gth758y/poe_garHAge/board_front.png

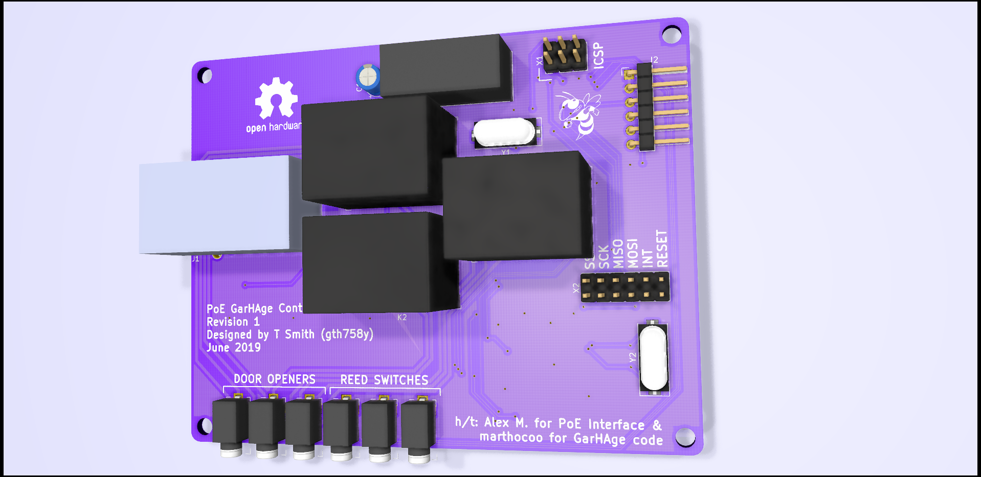
board_front.png
