gth758y/poe_garHAge/board_rear.png

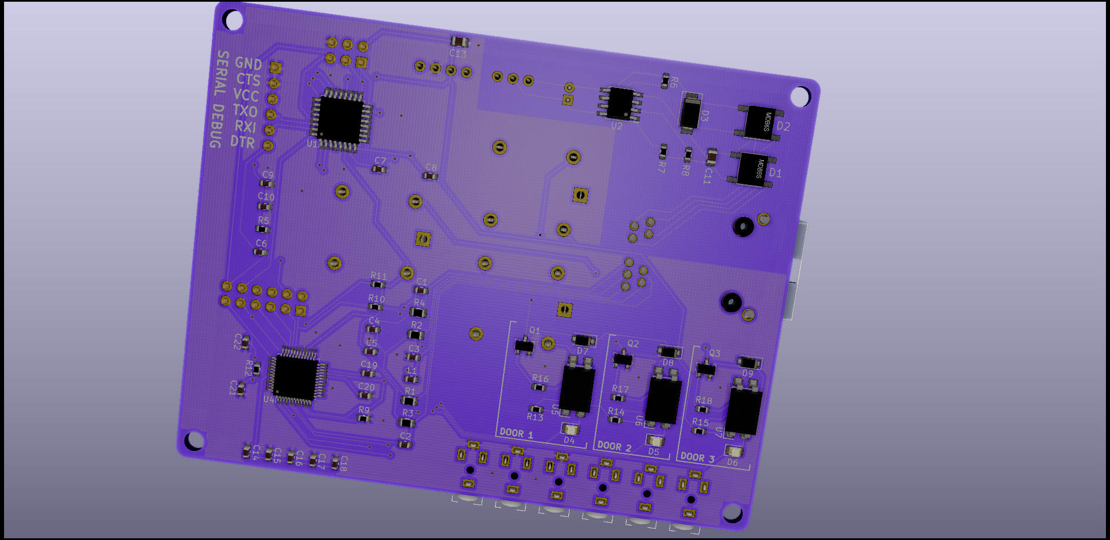
board_rear.png
