gth758y/poe_garHAge/README.md

# poe_garHAge

in-work version of the PoE powered, MQTT garage door controller
