gth758y/poe_garHAge/kicad/screenshots.pptx

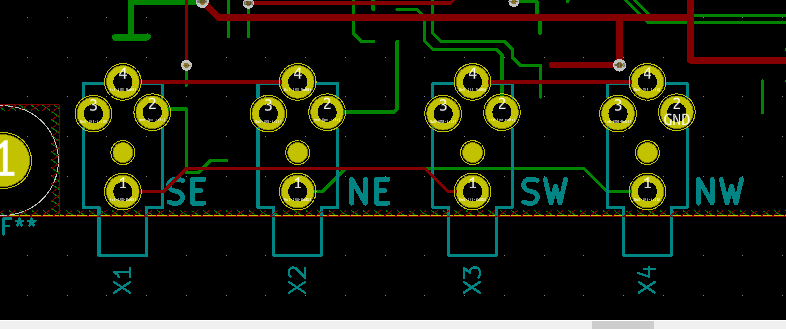
[picture p3: figure]

## Slide 2

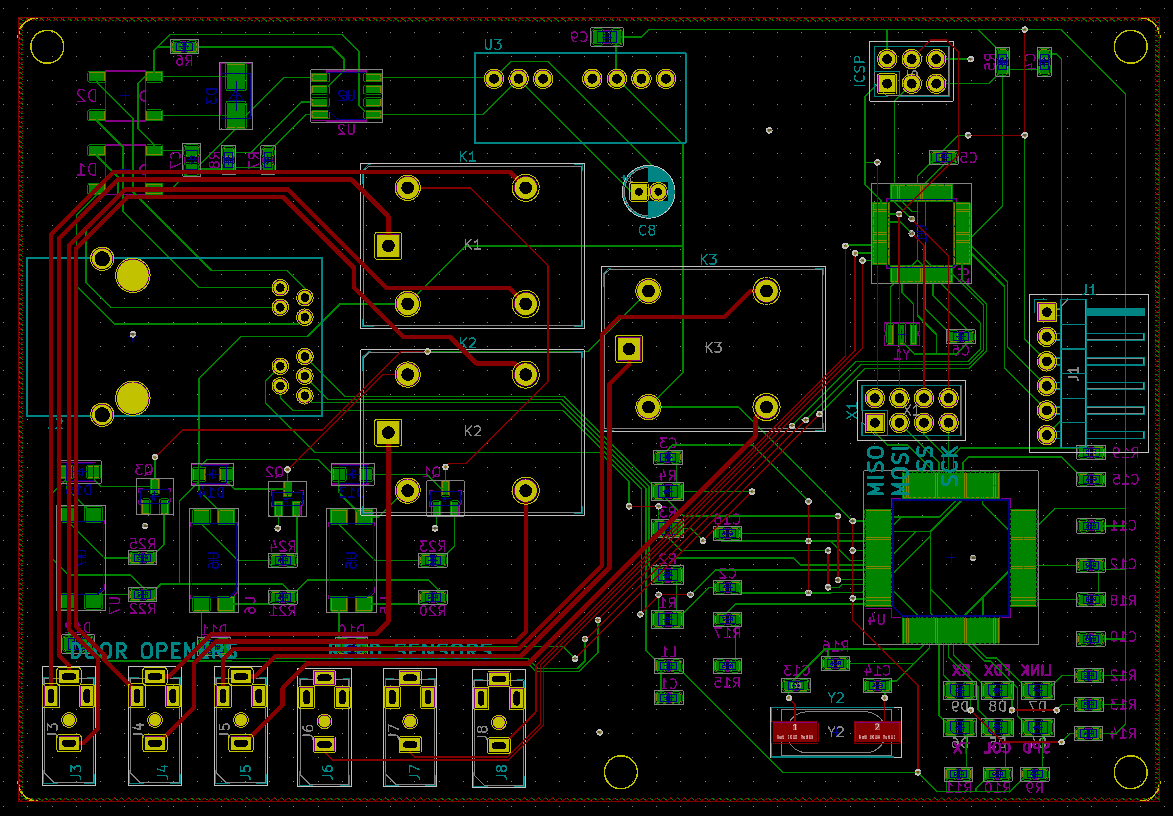
[picture p4: figure]

## Slide 3

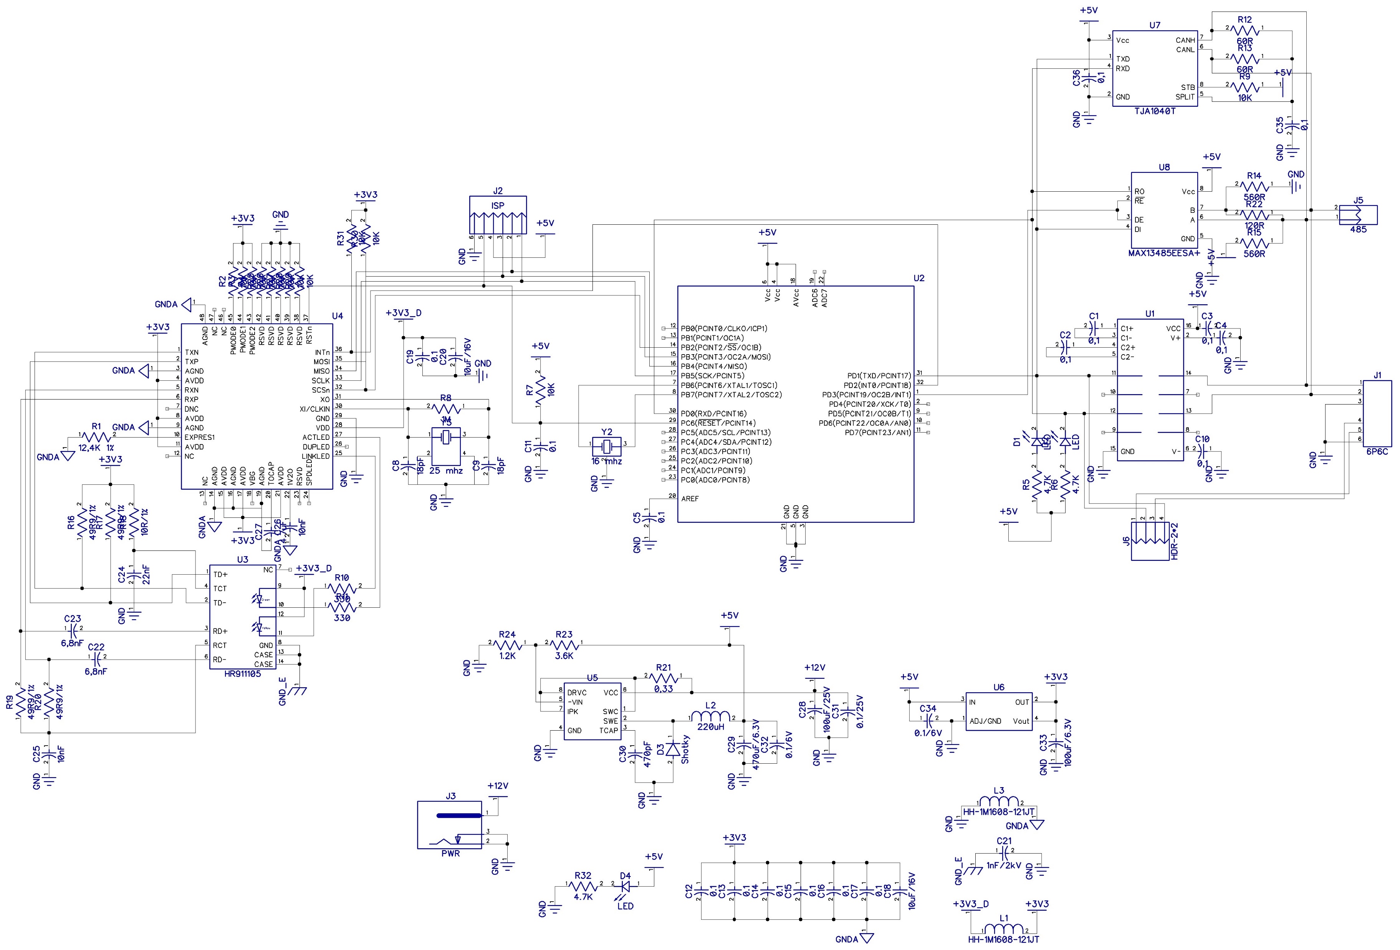
[picture p5: figure]

## Slide 4

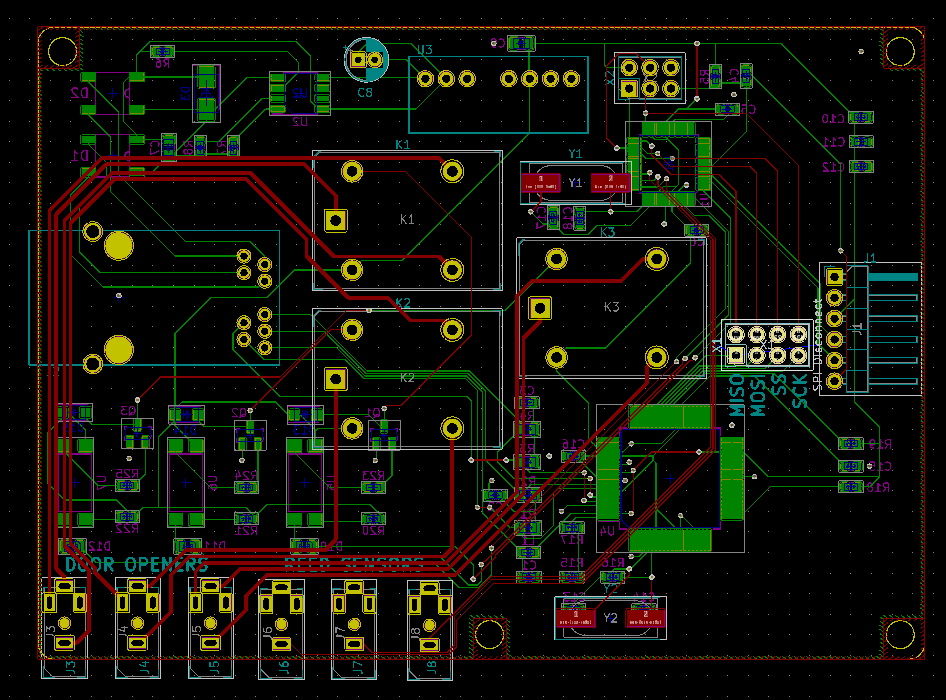
[picture p6: figure]
