gth758y/poe_garHAge/kicad/cad/PG02S4803A_markings.png

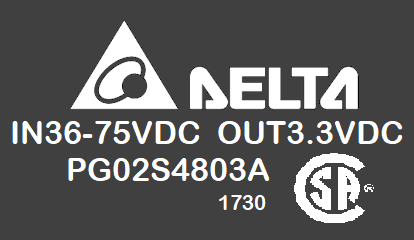
kicad/cad/PG02S4803A_markings.png
