gth758y/poe_garHAge/garHAge_v2_BOM.xlsx

Source: | Z:\00 - tyler\arduino projects\poe garHAge\garHAge_v2\garHAge_v2.sch
Date: | 2019-07-14 19:01
Tool: | Eeschema (5.0.2)-1
Generator: | C:\Program Files\KiCad\bin\scripting\plugins/bom_csv_grouped_by_value.py
Component Count: | 88
Individual Components:
Item | Qty | Reference(s) | Value | Footprint | Digi-Key_PN | DigiKey Part Number | Description | Datasheet | Category | DK_Datasheet_Link | DK_Detail_Page | Family | MPN | Manufacturer | Status
 |  | C1 | 6.8n | Capacitor_SMD:C_0805_2012Metric |  |  |  | ~
 |  | C2 | 6.8n | Capacitor_SMD:C_0805_2012Metric |  |  |  | ~
 |  | C3 | 22n | Capacitor_SMD:C_0805_2012Metric |  |  |  | ~
 |  | C4 | 10n | Capacitor_SMD:C_0805_2012Metric |  |  |  | ~
 |  | C5 | 18p | Capacitor_SMD:C_0603_1608Metric |  |  |  | ~
 |  | C6 | 18p | Capacitor_SMD:C_0603_1608Metric |  |  |  | ~
 |  | C7 | 100n | Capacitor_SMD:C_0805_2012Metric |  |  |  | ~
 |  | C8 | 100n | Capacitor_SMD:C_0805_2012Metric |  |  |  | ~
 |  | C9 | 100n | Capacitor_SMD:C_0805_2012Metric |  |  |  | ~
 |  | C10 | 100n | Capacitor_SMD:C_0805_2012Metric |  |  |  | ~
 |  | C11 | 22u | Capacitor_THT:CP_Radial_D5.0mm_P2.00mm |  |  |  | ~
 |  | C12 | 10u | Capacitor_SMD:C_0805_2012Metric |  |  |  | ~
 |  | C13 | 10u/16V | Capacitor_SMD:C_0805_2012Metric |  |  |  | ~
 |  | C14 | 10u/16V | Capacitor_SMD:C_0805_2012Metric |  |  |  | ~
 |  | C15 | 100n | Capacitor_SMD:C_0805_2012Metric |  |  |  | ~
 |  | C16 | 100n | Capacitor_SMD:C_0805_2012Metric |  |  |  | ~
 |  | C17 | 100n | Capacitor_SMD:C_0805_2012Metric |  |  |  | ~
 |  | C18 | 100n | Capacitor_SMD:C_0805_2012Metric |  |  |  | ~
 |  | C19 | 100n | Capacitor_SMD:C_0805_2012Metric |  |  |  | ~
 |  | C20 | 100n | Capacitor_SMD:C_0805_2012Metric |  |  |  | ~
 |  | C21 | 100n | Capacitor_SMD:C_0805_2012Metric |  |  |  | ~
 |  | C22 | 10n | Capacitor_SMD:C_0805_2012Metric |  |  |  | ~
 |  | C23 | 4.7u | Capacitor_SMD:C_0805_2012Metric |  |  |  | ~
 |  | C24 | 18p | Capacitor_SMD:C_0603_1608Metric |  |  |  | ~
 |  | C25 | 18p | Capacitor_SMD:C_0603_1608Metric |  |  |  | ~
 |  | D1 | LED | LED_SMD:LED_1206_3216Metric_Pad1.42x1.75mm_HandSolder |  |  |  | ~
 |  | D2 | LED | LED_SMD:LED_1206_3216Metric_Pad1.42x1.75mm_HandSolder |  |  |  | ~
 |  | D3 | MDB6S | tyler_components:Micro-DIP-4 |  | MDB6SFSCT-ND |  | https://www.fairchildsemi.com/datasheets/MD/MDB10S.pdf
 |  | D4 | MDB6S | tyler_components:Micro-DIP-4 |  | MDB6SFSCT-ND |  | https://www.fairchildsemi.com/datasheets/MD/MDB10S.pdf
 |  | D5 | SMAJ58A | Diode_SMD:D_SMA
 |  | D6 | LED | LED_SMD:LED_1206_3216Metric_Pad1.42x1.75mm_HandSolder |  |  |  | ~
 |  | D7 | LED | LED_SMD:LED_1206_3216Metric_Pad1.42x1.75mm_HandSolder |  |  |  | ~
 |  | D8 | LED | LED_SMD:LED_1206_3216Metric_Pad1.42x1.75mm_HandSolder |  |  |  | ~
 |  | D9 | LED | LED_SMD:LED_1206_3216Metric_Pad1.42x1.75mm_HandSolder |  |  |  | ~
 |  | D10 | LED | LED_SMD:LED_1206_3216Metric_Pad1.42x1.75mm_HandSolder |  |  |  | ~
 |  | D11 | CGRKM4007-HF | Diode_SMD:D_SOD-123F
 |  | D12 | CGRKM4007-HF | Diode_SMD:D_SOD-123F
 |  | D13 | CGRKM4007-HF | Diode_SMD:D_SOD-123F
 |  | J1 | SJ1-2503A | digikey-footprints:Headphone_Jack_2.5mm_SJ1-2503A | CP1-2503A-ND |  | CONN JACK STEREO 2.5MM R/A | https://www.cui.com/product/resource/digikeypdf/sj1-2503a.pdf | Connectors, Interconnects | https://www.cui.com/product/resource/digikeypdf/sj1-2503a.pdf | /product-detail/en/cui-inc/SJ1-2503A/CP1-2503A-ND/738680 | Barrel - Audio Connectors | SJ1-2503A | CUI Inc. | Active
 |  | J2 | SJ1-2503A | digikey-footprints:Headphone_Jack_2.5mm_SJ1-2503A | CP1-2503A-ND |  | CONN JACK STEREO 2.5MM R/A | https://www.cui.com/product/resource/digikeypdf/sj1-2503a.pdf | Connectors, Interconnects | https://www.cui.com/product/resource/digikeypdf/sj1-2503a.pdf | /product-detail/en/cui-inc/SJ1-2503A/CP1-2503A-ND/738680 | Barrel - Audio Connectors | SJ1-2503A | CUI Inc. | Active
 |  | J3 | SJ1-2503A | digikey-footprints:Headphone_Jack_2.5mm_SJ1-2503A | CP1-2503A-ND |  | CONN JACK STEREO 2.5MM R/A | https://www.cui.com/product/resource/digikeypdf/sj1-2503a.pdf | Connectors, Interconnects | https://www.cui.com/product/resource/digikeypdf/sj1-2503a.pdf | /product-detail/en/cui-inc/SJ1-2503A/CP1-2503A-ND/738680 | Barrel - Audio Connectors | SJ1-2503A | CUI Inc. | Active
 |  | J4 | 0813-1X1T-57-F | tyler_components:0813-1X1T-57-F_RJ45-Jack |  | 507-1421-ND |  | http://belfuse.com/pdfs/0813-1X1T-57-F.pdf
 |  | J5 | SJ1-2503A | digikey-footprints:Headphone_Jack_2.5mm_SJ1-2503A | CP1-2503A-ND |  | CONN JACK STEREO 2.5MM R/A | https://www.cui.com/product/resource/digikeypdf/sj1-2503a.pdf | Connectors, Interconnects | https://www.cui.com/product/resource/digikeypdf/sj1-2503a.pdf | /product-detail/en/cui-inc/SJ1-2503A/CP1-2503A-ND/738680 | Barrel - Audio Connectors | SJ1-2503A | CUI Inc. | Active
 |  | J6 | SJ1-2503A | digikey-footprints:Headphone_Jack_2.5mm_SJ1-2503A | CP1-2503A-ND |  | CONN JACK STEREO 2.5MM R/A | https://www.cui.com/product/resource/digikeypdf/sj1-2503a.pdf | Connectors, Interconnects | https://www.cui.com/product/resource/digikeypdf/sj1-2503a.pdf | /product-detail/en/cui-inc/SJ1-2503A/CP1-2503A-ND/738680 | Barrel - Audio Connectors | SJ1-2503A | CUI Inc. | Active
 |  | J7 | SJ1-2503A | digikey-footprints:Headphone_Jack_2.5mm_SJ1-2503A | CP1-2503A-ND |  | CONN JACK STEREO 2.5MM R/A | https://www.cui.com/product/resource/digikeypdf/sj1-2503a.pdf | Connectors, Interconnects | https://www.cui.com/product/resource/digikeypdf/sj1-2503a.pdf | /product-detail/en/cui-inc/SJ1-2503A/CP1-2503A-ND/738680 | Barrel - Audio Connectors | SJ1-2503A | CUI Inc. | Active
 |  | K1 | G5LE-14_DC3 | digikey-footprints:Relay_THT_G5LE-14 | Z3326-ND |  | RELAY GEN PURPOSE SPDT 10A 5V | https://omronfs.omron.com/en_US/ecb/products/pdf/en-g5le.pdf | Relays | https://omronfs.omron.com/en_US/ecb/products/pdf/en-g5le.pdf | /product-detail/en/omron-electronics-inc-emc-div/G5LE-14-DC3/Z3326-ND/1815628 | Power Relays, Over 2 Amps | G5LE-14 DC3 | Omron Electronics Inc-EMC Div | Active
 |  | K2 | G5LE-14_DC3 | digikey-footprints:Relay_THT_G5LE-14 | Z3326-ND |  | RELAY GEN PURPOSE SPDT 10A 5V | https://omronfs.omron.com/en_US/ecb/products/pdf/en-g5le.pdf | Relays | https://omronfs.omron.com/en_US/ecb/products/pdf/en-g5le.pdf | /product-detail/en/omron-electronics-inc-emc-div/G5LE-14-DC3/Z3326-ND/1815628 | Power Relays, Over 2 Amps | G5LE-14 DC3 | Omron Electronics Inc-EMC Div | Active
 |  | K3 | G5LE-14_DC3 | digikey-footprints:Relay_THT_G5LE-14 | Z3326-ND |  | RELAY GEN PURPOSE SPDT 10A 5V | https://omronfs.omron.com/en_US/ecb/products/pdf/en-g5le.pdf | Relays | https://omronfs.omron.com/en_US/ecb/products/pdf/en-g5le.pdf | /product-detail/en/omron-electronics-inc-emc-div/G5LE-14-DC3/Z3326-ND/1815628 | Power Relays, Over 2 Amps | G5LE-14 DC3 | Omron Electronics Inc-EMC Div | Active
 |  | L1 | 1uH | Capacitor_SMD:C_0805_2012Metric |  |  |  | ~
 |  | Q1 | BC846B_215 | digikey-footprints:SOT-23-3 | 1727-2920-1-ND |  | TRANS NPN 65V 0.1A SOT23 | https://assets.nexperia.com/documents/data-sheet/BC846_SER.pdf | Discrete Semiconductor Products | https://assets.nexperia.com/documents/data-sheet/BC846_SER.pdf | /product-detail/en/nexperia-usa-inc/BC846B,215/1727-2920-1-ND/763459 | Transistors - Bipolar (BJT) - Single | BC846B,215 | Nexperia USA Inc. | Active
 |  | Q2 | BC846B_215 | digikey-footprints:SOT-23-3 | 1727-2920-1-ND |  | TRANS NPN 65V 0.1A SOT23 | https://assets.nexperia.com/documents/data-sheet/BC846_SER.pdf | Discrete Semiconductor Products | https://assets.nexperia.com/documents/data-sheet/BC846_SER.pdf | /product-detail/en/nexperia-usa-inc/BC846B,215/1727-2920-1-ND/763459 | Transistors - Bipolar (BJT) - Single | BC846B,215 | Nexperia USA Inc. | Active
 |  | Q3 | BC846B_215 | digikey-footprints:SOT-23-3 | 1727-2920-1-ND |  | TRANS NPN 65V 0.1A SOT23 | https://assets.nexperia.com/documents/data-sheet/BC846_SER.pdf | Discrete Semiconductor Products | https://assets.nexperia.com/documents/data-sheet/BC846_SER.pdf | /product-detail/en/nexperia-usa-inc/BC846B,215/1727-2920-1-ND/763459 | Transistors - Bipolar (BJT) - Single | BC846B,215 | Nexperia USA Inc. | Active
 |  | R1 | 49.9 | Resistor_SMD:R_0805_2012Metric |  |  |  | ~
 |  | R2 | 49.9 | Resistor_SMD:R_0805_2012Metric |  |  |  | ~
 |  | R3 | 49.9 | Resistor_SMD:R_0805_2012Metric |  |  |  | ~
 |  | R4 | 49.9 | Resistor_SMD:R_0805_2012Metric |  |  |  | ~
 |  | R5 | 330 | Resistor_SMD:R_0805_2012Metric |  |  |  | ~
 |  | R6 | 12k | Resistor_SMD:R_0805_2012Metric |  |  |  | ~
 |  | R7 | 330 | Resistor_SMD:R_0805_2012Metric |  |  |  | ~
 |  | R8 | 24.9k | Resistor_SMD:R_0805_2012Metric |  |  |  | ~
 |  | R9 | 178k | Resistor_SMD:R_0805_2012Metric |  |  |  | ~
 |  | R10 | 4420 | Resistor_SMD:R_0805_2012Metric |  |  |  | ~
 |  | R11 | 10k | Resistor_SMD:R_0805_2012Metric |  |  |  | ~
 |  | R12 | 10k | Resistor_SMD:R_0805_2012Metric |  |  |  | ~
 |  | R13 | 10k | Resistor_SMD:R_0805_2012Metric |  |  |  | ~
 |  | R14 | 12.4k | Resistor_SMD:R_0805_2012Metric |  |  |  | ~
 |  | R15 | 1M | Resistor_SMD:R_0805_2012Metric |  |  |  | ~
 |  | R16 | 330 | Resistor_SMD:R_0805_2012Metric |  |  |  | ~
 |  | R17 | 330 | Resistor_SMD:R_0805_2012Metric |  |  |  | ~
 |  | R18 | 100 | Resistor_SMD:R_0805_2012Metric |  |  |  | ~
 |  | R19 | 100 | Resistor_SMD:R_0805_2012Metric |  |  |  | ~
 |  | R20 | 100 | Resistor_SMD:R_0805_2012Metric |  |  |  | ~
 |  | R21 | 1k | Resistor_SMD:R_0805_2012Metric |  |  |  | ~
 |  | R22 | 1k | Resistor_SMD:R_0805_2012Metric |  |  |  | ~
 |  | R23 | 1k | Resistor_SMD:R_0805_2012Metric |  |  |  | ~
 |  | U1 | ATMEGA328P-AU | digikey-footprints:TQFP-32_7x7mm | ATMEGA328P-AU-ND |  | IC MCU 8BIT 32KB FLASH 32TQFP | http://www.microchip.com/mymicrochip/filehandler.aspx?ddocname=en589968 | Integrated Circuits (ICs) | http://www.microchip.com/mymicrochip/filehandler.aspx?ddocname=en589968 | /product-detail/en/microchip-technology/ATMEGA328P-AU/ATMEGA328P-AU-ND/1832260 | Embedded - Microcontrollers | ATMEGA328P-AU | Microchip Technology | Active
 |  | U2 | NCP1090 | Package_SO:SOIC-8_3.9x4.9mm_P1.27mm |  | NCP1090DGOS-ND |  | http://www.onsemi.com/pub/Collateral/NCP1090-D.PDF
 |  | U3 | PG02S4805A | tyler_components:PG02S |  | 941-1186-ND |  | http://www.deltaww.com/filecenter/products/download/01/0102/datasheet/DS_PG02S.pdf
 |  | U4 | W5500 | Package_QFP:LQFP-48_7x7mm_P0.5mm
 |  | U5 | LTV-817S | tyler_components:DIP-4_SMD_GullWing | 160-1366-5-ND |  | OPTOISOLATR 5KV TRANSISTOR 4-DIP | http://optoelectronics.liteon.com/upload/download/DS-70-96-0016/LTV-8X7%20series%20201610%20.pdf | Isolators | http://optoelectronics.liteon.com/upload/download/DS-70-96-0016/LTV-8X7%20series%20201610%20.pdf | /product-detail/en/lite-on-inc/LTV-817/160-1366-5-ND/385836 | Optoisolators - Transistor, Photovoltaic Output | LTV-817 | Lite-On Inc. | Active
 |  | U6 | LTV-817S | tyler_components:DIP-4_SMD_GullWing | 160-1366-5-ND |  | OPTOISOLATR 5KV TRANSISTOR 4-DIP | http://optoelectronics.liteon.com/upload/download/DS-70-96-0016/LTV-8X7%20series%20201610%20.pdf | Isolators | http://optoelectronics.liteon.com/upload/download/DS-70-96-0016/LTV-8X7%20series%20201610%20.pdf | /product-detail/en/lite-on-inc/LTV-817/160-1366-5-ND/385836 | Optoisolators - Transistor, Photovoltaic Output | LTV-817S | Lite-On Inc. | Active
 |  | U7 | LTV-817S | tyler_components:DIP-4_SMD_GullWing | 160-1366-5-ND |  | OPTOISOLATR 5KV TRANSISTOR 4-DIP | http://optoelectronics.liteon.com/upload/download/DS-70-96-0016/LTV-8X7%20series%20201610%20.pdf | Isolators | http://optoelectronics.liteon.com/upload/download/DS-70-96-0016/LTV-8X7%20series%20201610%20.pdf | /product-detail/en/lite-on-inc/LTV-817/160-1366-5-ND/385836 | Optoisolators - Transistor, Photovoltaic Output | LTV-817S | Lite-On Inc. | Active
 |  | X1 | ICSP | Connector_PinHeader_2.54mm:PinHeader_2x03_P2.54mm_Vertical
 |  | X2 | Serial Pwr Disconnect | Connector_PinHeader_2.54mm:PinHeader_1x02_P2.54mm_Vertical |  |  |  | ~
 |  | X3 | Serial Interface | Connector_PinHeader_2.54mm:PinHeader_1x06_P2.54mm_Horizontal
 |  | X4 | SPI Disconnect | Connector_PinHeader_2.54mm:PinHeader_2x06_P2.54mm_Vertical |  |  |  | ~
 |  | Y1 | 8MHz | Crystal:Crystal_SMD_5032-2Pin_5.0x3.2mm |  |  |  | https://www.ctscorp.com/wp-content/uploads/ATS-ATSSM.pdf
 |  | Y2 | 25MHz | Crystal:Crystal_SMD_5032-2Pin_5.0x3.2mm |  |  |  | ~
Collated Components:
Item | Qty | Reference(s) | Value | Footprint | Digi-Key_PN | DigiKey Part Number | Description | Datasheet | Category | DK_Datasheet_Link | DK_Detail_Page | Family | MPN | Manufacturer | Status
1 | 2 | C1, C2 | 6.8n | Capacitor_SMD:C_0805_2012Metric | 311-1135-1-ND |  |  | ~
2 | 1 | C3 | 22n | Capacitor_SMD:C_0805_2012Metric | 311-3547-1-ND |  |  | ~
3 | 2 | C4, C22 | 10n | Capacitor_SMD:C_0805_2012Metric | 311-1778-1-ND |  |  | ~
4 | 4 | C5, C6, C24, C25 | 18p | Capacitor_SMD:C_0603_1608Metric | 311-1061-1-ND |  |  | ~
5 | 11 | C7, C8, C9, C10, C15, C16, C17, C18, C19, C20, C21 | 100n | Capacitor_SMD:C_0805_2012Metric | 311-1858-1-ND |  |  | ~
6 | 1 | C11 | 22u | Capacitor_THT:CP_Radial_D5.0mm_P2.00mm | 493-12798-1-ND |  |  | ~
7 | 3 | C12, C13, C14 | 10u | Capacitor_SMD:C_0805_2012Metric | 311-2085-1-ND |  |  | ~
9 | 1 | C23 | 4.7u | Capacitor_SMD:C_0805_2012Metric | 311-1871-1-ND |  |  | ~
10 | 4 | D1, D8, D9, D10 | BLUE | LED_SMD:LED_1206_3216Metric_Pad1.42x1.75mm_HandSolder | 160-1643-1-ND |  |  | ~
 | 1 | D2 | RED | LED_SMD:LED_1206_3216Metric_Pad1.42x1.75mm_HandSolder | 160-1457-1-ND
 | 1 | D7 | YELLOW | LED_SMD:LED_1206_3216Metric_Pad1.42x1.75mm_HandSolder | 160-1406-1-ND
 | 1 | D6 | GREEN | LED_SMD:LED_1206_3216Metric_Pad1.42x1.75mm_HandSolder | 160-2018-1-ND
11 | 2 | D3, D4 | MDB6S | tyler_components:Micro-DIP-4 | MDB6SFSCT-ND | MDB6SFSCT-ND |  | https://www.fairchildsemi.com/datasheets/MD/MDB10S.pdf
12 | 1 | D5 | SMAJ58A | Diode_SMD:D_SMA | SMAJ58A-E3-61GICT-ND
13 | 3 | D11, D12, D13 | CGRKM4007-HF | Diode_SMD:D_SOD-123F | 641-1514-1-ND
14 | 6 | J1, J2, J3, J5, J6, J7 | SJ1-2503A | digikey-footprints:Headphone_Jack_2.5mm_SJ1-2503A | CP1-2503A-ND |  | CONN JACK STEREO 2.5MM R/A | https://www.cui.com/product/resource/digikeypdf/sj1-2503a.pdf | Connectors, Interconnects | https://www.cui.com/product/resource/digikeypdf/sj1-2503a.pdf | /product-detail/en/cui-inc/SJ1-2503A/CP1-2503A-ND/738680 | Barrel - Audio Connectors | SJ1-2503A | CUI Inc. | Active
15 | 1 | J4 | 0813-1X1T-57-F | tyler_components:0813-1X1T-57-F_RJ45-Jack | 507-1421-ND |  |  | http://belfuse.com/pdfs/0813-1X1T-57-F.pdf
16 | 3 | K1, K2, K3 | G5LE-14_DC3 | digikey-footprints:Relay_THT_G5LE-14 | Z3326-ND |  | RELAY GEN PURPOSE SPDT 10A 5V | https://omronfs.omron.com/en_US/ecb/products/pdf/en-g5le.pdf | Relays | https://omronfs.omron.com/en_US/ecb/products/pdf/en-g5le.pdf | /product-detail/en/omron-electronics-inc-emc-div/G5LE-14-DC3/Z3326-ND/1815628 | Power Relays, Over 2 Amps | G5LE-14 DC3 | Omron Electronics Inc-EMC Div | Active
17 | 1 | L1 | 1uH | Capacitor_SMD:C_0805_2012Metric | 490-16678-1-ND |  |  | ~
18 | 3 | Q1, Q2, Q3 | BC846B_215 | digikey-footprints:SOT-23-3 | 1727-2920-1-ND |  | TRANS NPN 65V 0.1A SOT23 | https://assets.nexperia.com/documents/data-sheet/BC846_SER.pdf | Discrete Semiconductor Products | https://assets.nexperia.com/documents/data-sheet/BC846_SER.pdf | /product-detail/en/nexperia-usa-inc/BC846B,215/1727-2920-1-ND/763459 | Transistors - Bipolar (BJT) - Single | BC846B,215 | Nexperia USA Inc. | Active
19 | 4 | R1, R2, R3, R4 | 49.9 | Resistor_SMD:R_0805_2012Metric | 311-49.9CRCT-ND |  |  | ~
20 | 4 | R5, R7, R16, R17 | 330 | Resistor_SMD:R_0805_2012Metric | 311-330CRCT-ND |  |  | ~
21 | 1 | R6 | 12k | Resistor_SMD:R_0805_2012Metric | 311-12.0KCRCT-ND |  |  | ~
22 | 1 | R8 | 24.9k | Resistor_SMD:R_0805_2012Metric | 311-24.9KCRCT-ND |  |  | ~
23 | 1 | R9 | 178k | Resistor_SMD:R_0805_2012Metric | 311-178KCRCT-ND |  |  | ~
24 | 1 | R10 | 4420 | Resistor_SMD:R_0805_2012Metric | 311-4.42KCRCT-ND |  |  | ~
25 | 3 | R11, R12, R13 | 10k | Resistor_SMD:R_0805_2012Metric | 311-10.0KCRCT-ND |  |  | ~
26 | 1 | R14 | 12.4k | Resistor_SMD:R_0805_2012Metric | 311-12.4KCRCT-ND |  |  | ~
27 | 1 | R15 | 1M | Resistor_SMD:R_0805_2012Metric | 311-1.00MCRCT-ND |  |  | ~
28 | 3 | R18, R19, R20 | 100 | Resistor_SMD:R_0805_2012Metric | 311-100CRCT-ND |  |  | ~
29 | 3 | R21, R22, R23 | 1k | Resistor_SMD:R_0805_2012Metric | 311-1.00KCRCT-ND |  |  | ~
30 | 1 | U1 | ATMEGA328P-AU | digikey-footprints:TQFP-32_7x7mm | ATMEGA328P-AU-ND |  | IC MCU 8BIT 32KB FLASH 32TQFP | http://www.microchip.com/mymicrochip/filehandler.aspx?ddocname=en589968 | Integrated Circuits (ICs) | http://www.microchip.com/mymicrochip/filehandler.aspx?ddocname=en589968 | /product-detail/en/microchip-technology/ATMEGA328P-AU/ATMEGA328P-AU-ND/1832260 | Embedded - Microcontrollers | ATMEGA328P-AU | Microchip Technology | Active
31 | 1 | U2 | NCP1090 | Package_SO:SOIC-8_3.9x4.9mm_P1.27mm | NCP1090DGOS-ND | NCP1090DGOS-ND |  | http://www.onsemi.com/pub/Collateral/NCP1090-D.PDF
32 | 1 | U3 | PG02S4805A | tyler_components:PG02S | 941-1185-ND |  |  | http://www.deltaww.com/filecenter/products/download/01/0102/datasheet/DS_PG02S.pdf
33 | 1 | U4 | W5500 | Package_QFP:LQFP-48_7x7mm_P0.5mm | 1278-1021-ND
34 | 3 | U5, U6, U7 | LTV-817S | tyler_components:DIP-4_SMD_GullWing | 160-1367-5-ND |  | OPTOISOLATR 5KV TRANSISTOR 4-DIP | http://optoelectronics.liteon.com/upload/download/DS-70-96-0016/LTV-8X7%20series%20201610%20.pdf | Isolators | http://optoelectronics.liteon.com/upload/download/DS-70-96-0016/LTV-8X7%20series%20201610%20.pdf | /product-detail/en/lite-on-inc/LTV-817/160-1366-5-ND/385836 | Optoisolators - Transistor, Photovoltaic Output | LTV-817 | Lite-On Inc. | Active
35 | 1 | X1 | ICSP | Connector_PinHeader_2.54mm:PinHeader_2x03_P2.54mm_Vertical | 952-1779-ND
36 | 1 | X2 | Serial Pwr Disconnect | Connector_PinHeader_2.54mm:PinHeader_1x02_P2.54mm_Vertical | 952-2262-ND |  |  | ~
37 | 1 | X3 | Serial Interface | Connector_PinHeader_2.54mm:PinHeader_1x06_P2.54mm_Horizontal
38 | 1 | X4 | SPI Disconnect | Connector_PinHeader_2.54mm:PinHeader_2x06_P2.54mm_Vertical | 952-2126-ND |  |  | ~
39 | 1 | Y1 | 8MHz | Crystal:Crystal_SMD_5032-2Pin_5.0x3.2mm | 535-10630-1-ND |  |  | https://www.ctscorp.com/wp-content/uploads/ATS-ATSSM.pdf
40 | 1 | Y2 | 25MHz | Crystal:Crystal_SMD_5032-2Pin_5.0x3.2mm | CTX1434CT-ND |  |  | ~
 | 6 | MISC1 |  | Stereo Connectors | CP-2501SP-ND
 | 7 | MISC2 |  | Jumpers | S9000-ND
