gth758y/poe_garHAge/kicad/bom.xlsx

Board | Type | RefDes | Value | Value Unit | Package | Digikey P/N | Qty | Unit Cost | Ext Cost
W5500 Breakout Board | Capacitor | C1-C5 | 100n | F | 0603 | 1276-1012-1-ND | 5 |  |  | 5,1276-1012-1-ND,C1-C5|W5500 Breakout Board
W5500 Breakout Board | Capacitor | C8-C9 | 18p | F | 0603 | 1276-1089-1-ND | 2 |  |  | 2,1276-1089-1-ND,C8-C9|W5500 Breakout Board
W5500 Breakout Board | Capacitor | C7 | 4.7u | F | 0603 | 1276-1907-1-ND | 1 |  |  | 1,1276-1907-1-ND,C7|W5500 Breakout Board
W5500 Breakout Board | Capacitor | C6 | 10n | F | 0603 | 1276-1921-1-ND | 1 |  |  | 1,1276-1921-1-ND,C6|W5500 Breakout Board
NCP1090 Breakout Board | Capacitor | C1 | 100n | F | 0805 | 1276-6840-1-ND | 1 |  |  | 1,1276-6840-1-ND,C1|NCP1090 Breakout Board
W5500 Breakout Board | IC | U1 | W5500 |  | LFFP-48 7x7 | 1278-1021-ND | 1 |  |  | 1,1278-1021-ND,U1|W5500 Breakout Board
Breadboard Only | IC | U5-U7 | LTV-817 |  | THT | 160-1366-5-ND | 3 | 0.41 |  | 3,160-1366-5-ND,U5-U7|Breadboard Only
Breadboard Only | Diode | D13-D15 | 1N4007 |  | THT | 1N4007FSCT-ND | 3 |  |  | 3,1N4007FSCT-ND,D13-D15|Breadboard Only
W5500 Breakout Board | Resistor | R2 | 1M | ohm | 0603 | 311-1.0MGRCT-ND | 1 |  |  | 1,311-1.0MGRCT-ND,R2|W5500 Breakout Board
W5500 Breakout Board | Resistor | R1 | 12.4k | ohm | 0603 | 311-12.4KHRCT-ND | 1 |  |  | 1,311-12.4KHRCT-ND,R1|W5500 Breakout Board
NCP1090 Breakout Board | Resistor | R2 | 178k | ohm | 0603 | 311-178KCRCT-ND | 1 |  |  | 1,311-178KCRCT-ND,R2|NCP1090 Breakout Board
NCP1090 Breakout Board | Resistor | R1 | 24.9k | ohm | 0603 | 311-24.9KCRCT-ND | 1 |  |  | 1,311-24.9KCRCT-ND,R1|NCP1090 Breakout Board
NCP1090 Breakout Board | Resistor | R3 | 4420 | ohm | 0603 | 311-4.42KCRCT-ND | 1 |  |  | 1,311-4.42KCRCT-ND,R3|NCP1090 Breakout Board
Ethernet Jack Breakout Board | Connector | X1 | 0813-1X1T-57-F |  |  | 507-1421-ND | 1 |  |  | 1,507-1421-ND,X1|Ethernet Jack Breakout Board
Breadboard Only | Inductor | L1 | 1u | H | THT | 77F1R0K-TR-RCCT-ND | 1 | 0.31 |  | 1,77F1R0K-TR-RCCT-ND ,L1|Breadboard Only
PCB & Breadboard | IC | U3 | PG02S4803A |  | 8-SIP | 941-1185-ND | 1 |  |  | 1,941-1185-ND,U3|PCB & Breadboard
Breadboard Only | Capacitor | C18, C17 | 18p | F | THT | BC1004CT-ND | 2 | 0.26 |  | 2,BC1004CT-ND,C18, C17|Breadboard Only
Breadboard Only | Transistor | Q1-Q3 | BC546 NPN |  | THT | BC546ATAFSCT-ND | 3 |  |  | 3,BC546ATAFSCT-ND,Q1-Q3|Breadboard Only
Breadboard Only | Resistor | R5 | 12k | ohm | THT | CF14JT12K0CT-ND | 1 | 0.1 |  | 1,CF14JT12K0CT-ND,R5|Breadboard Only
W5500 Breakout Board | Crystal | Y1 | 25 | MHz | 5x3.2mm | CTX1434CT-ND | 1 |  |  | 1,CTX1434CT-ND,Y1|W5500 Breakout Board
Breadboard Only | Crystal | Y1 | ATS08A-E |  | THT | CTX917-ND | 1 |  |  | 1,CTX917-ND,Y1|Breadboard Only
Breadboard Only | Capacitor | C1-C6 | 100n | F | THT | BC1101CT-ND | 6 | 0.23 |  | 6,BC1101CT-ND,C1-C6|Breadboard Only
NCP1090 Breakout Board | Diode | D1, D2 | MDB6S |  | SMA | MDB6SFSCT-ND | 2 |  |  | 2,MDB6SFSCT-ND,D1, D2|NCP1090 Breakout Board
NCP1090 Breakout Board | IC | U1 | NCP1090 |  | 8-SOIC | NCP1090DGOS-ND | 1 |  |  | 1,NCP1090DGOS-ND,U1|NCP1090 Breakout Board
NCP1090 Breakout Board | Diode | D3 | SMAJ58A |  | MDB62 | SMAJ58A-E3/61GICT-ND | 1 |  |  | 1,SMAJ58A-E3/61GICT-ND,D3|NCP1090 Breakout Board
Relay Breakout Board | Relay | K1 | G5LE-14 DC3 |  | SPDT | Z3326-ND | 1 |  |  | 1,Z3326-ND,K1|Relay Breakout Board
W5500 Breakout Board | Connector | X1-X2 | 1x10 |  | 2.54mm |  | 2
Relay Breakout Board | Connector | J1 | 1x5 |  | 2.54mm |  | 1
Ethernet Jack Breakout Board | Connector | X2 | 1x9 |  | 2.54mm |  | 1
NCP1090 Breakout Board | Connector | X1 | 1x4 |  | 2.54mm |  | 1
NCP1090 Breakout Board | Connector | X2 | 1x3 |  | 2.54mm |  | 1
Breadboard Only | Resistor | R1-R4 | 49.9 | ohm | THT |  | 4 | on hand
Breadboard Only | Capacitor | C8 | 22u | F | THT |  | 1 | on hand
Breadboard Only | Capacitor | C9 | 10u | F | THT |  | 1 | on hand
Breadboard Only | Resistor | R20-R22 | 1k | ohm | THT |  | 3 | on hand
Breadboard Only | Resistor | R23-R25 | 510 | ohm | THT |  | 3 | on hand
