gth758y/poe_garHAge/case/garHAge_v2.SLDASM

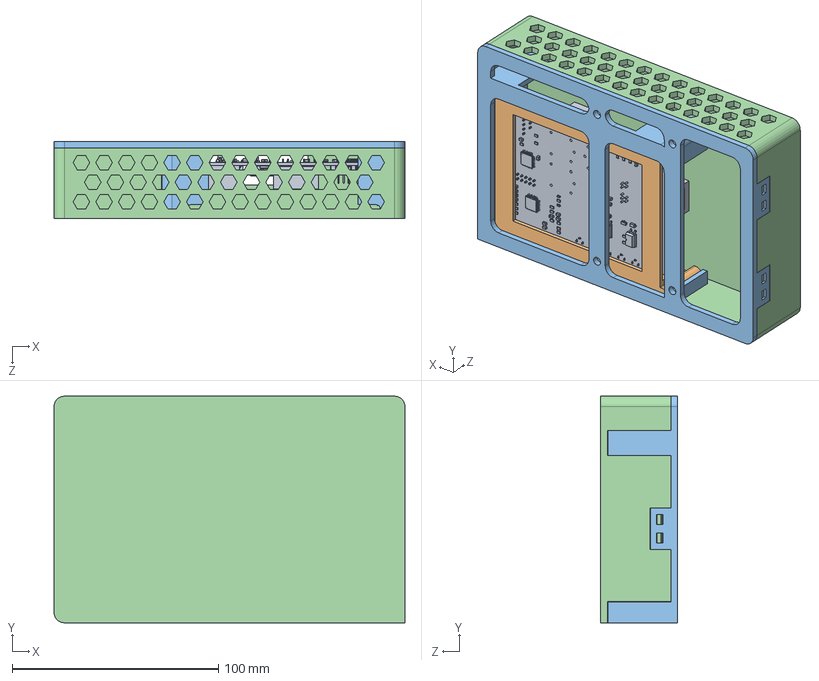
[picture p8: CAD file, 2024-01-09]
case/garHAge_v2.SLDASM
170.3 x 110.0 x 37.2 mm
pcb
pcb_mount
wall_mount_on_junction_box_2gang
cover
