gth758y/poe_garHAge/case/electrical_box_mounted.SLDASM

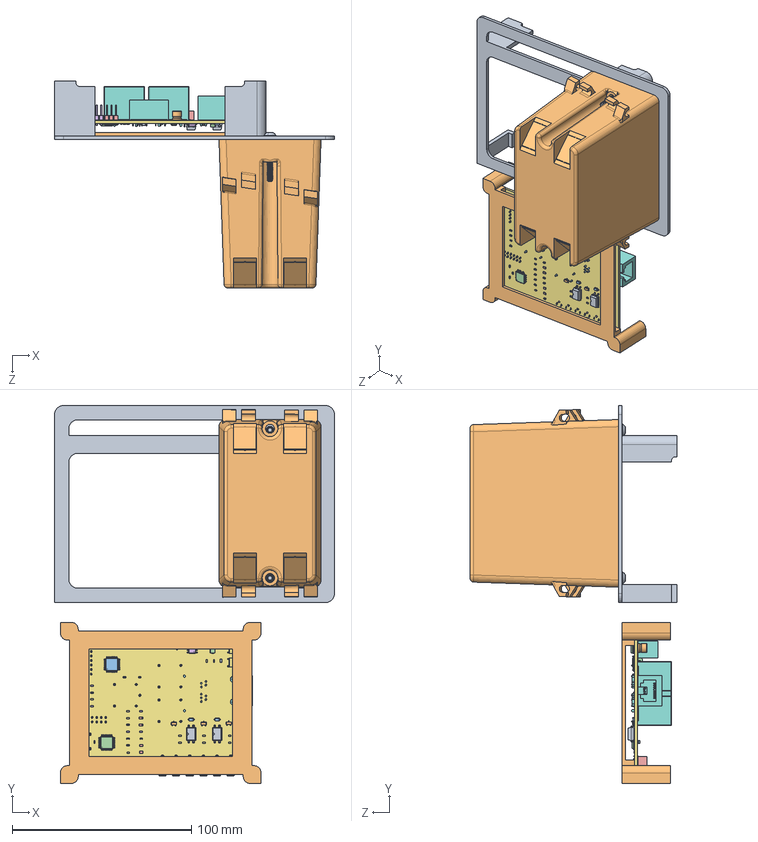
[picture p9: CAD file, 2024-01-09]
case/electrical_box_mounted.SLDASM
156.3 x 211.0 x 115.5 mm
wall_mount_on_junction_box
pcb_mount
G5LE Relay x 3
#6-32 screw x 2
SwitchBox
