gth758y/poe_garHAge/case/wall_mount_on_junction_box.SLDPRT

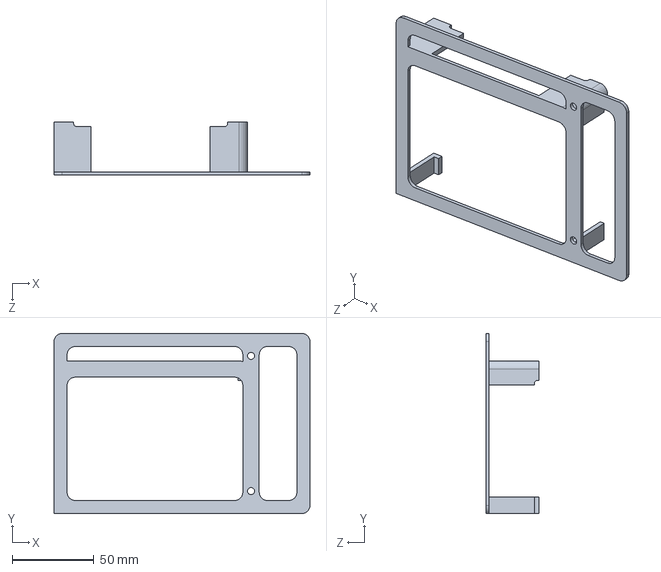
[picture p10: CAD file, 2024-01-09]
case/wall_mount_on_junction_box.SLDPRT
156.3 x 110.0 x 32.6 mm
