gth758y/poe_garHAge/kicad/cad/0813-1X1T-57-F.SLDPRT

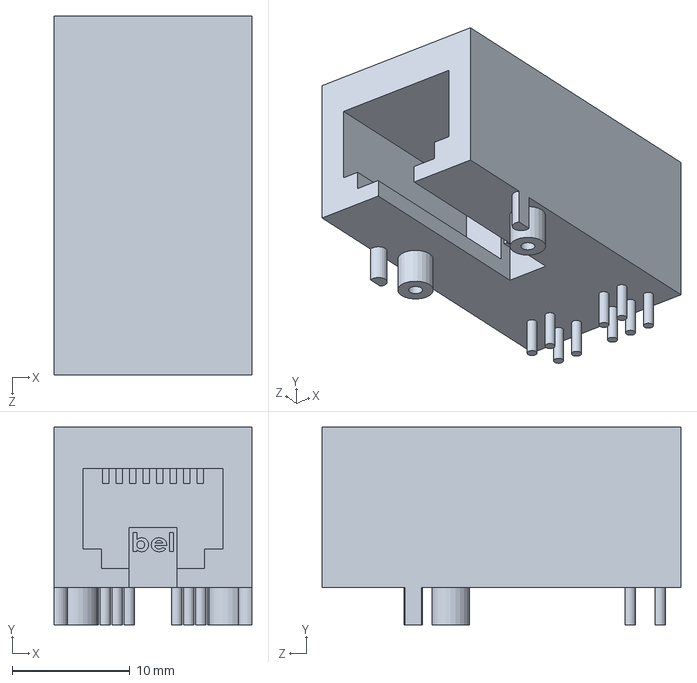
[picture p11: CAD file, 2019-06-20]
kicad/cad/0813-1X1T-57-F.SLDPRT
16.8 x 16.8 x 30.5 mm
