gth758y/poe_garHAge/kicad/PG02S4803A.STEP

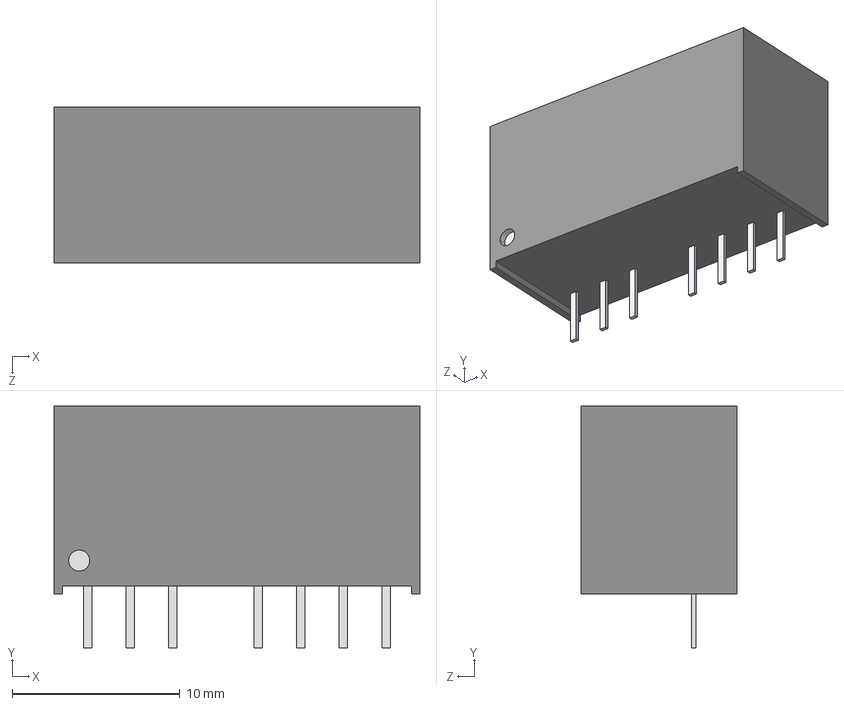
[picture p12: CAD file, 2019-06-20]
kicad/PG02S4803A.STEP
21.8 x 14.4 x 9.30 mm
