gth758y/poe_garHAge/case/wall_mount.SLDPRT

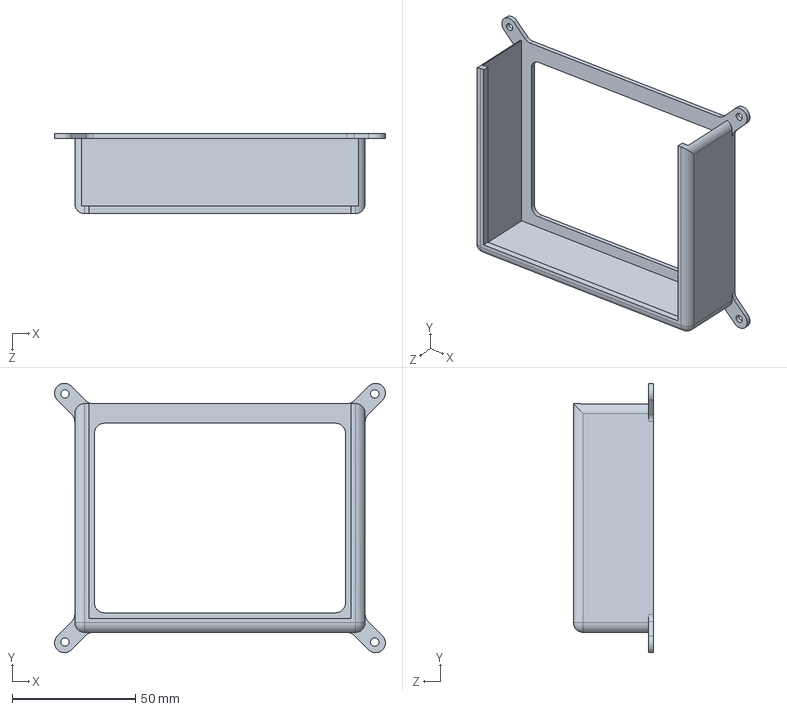
[picture p13: CAD file, 2024-01-09]
case/wall_mount.SLDPRT
134.5 x 109.5 x 32.6 mm
