gth758y/poe_garHAge/kicad/cad/PG02S4803A_markings.dxf

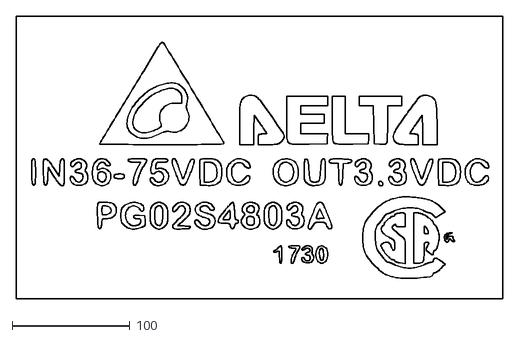
[picture p14: CAD file, 2019-06-20]
kicad/cad/PG02S4803A_markings.dxf
414.0 x 240.0
