gth758y/poe_garHAge/case/wall_mount_on_junction_box_2gang.SLDPRT

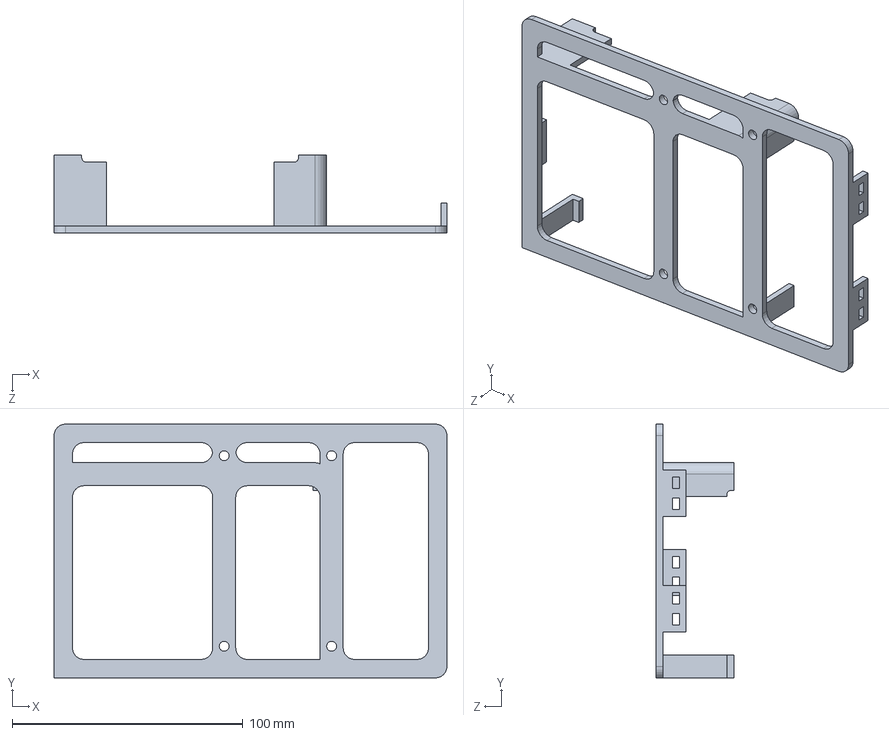
[picture p15: CAD file, 2024-01-09]
case/wall_mount_on_junction_box_2gang.SLDPRT
170.3 x 110.0 x 33.6 mm
