gth758y/poe_garHAge/case/pcb_mount.SLDPRT

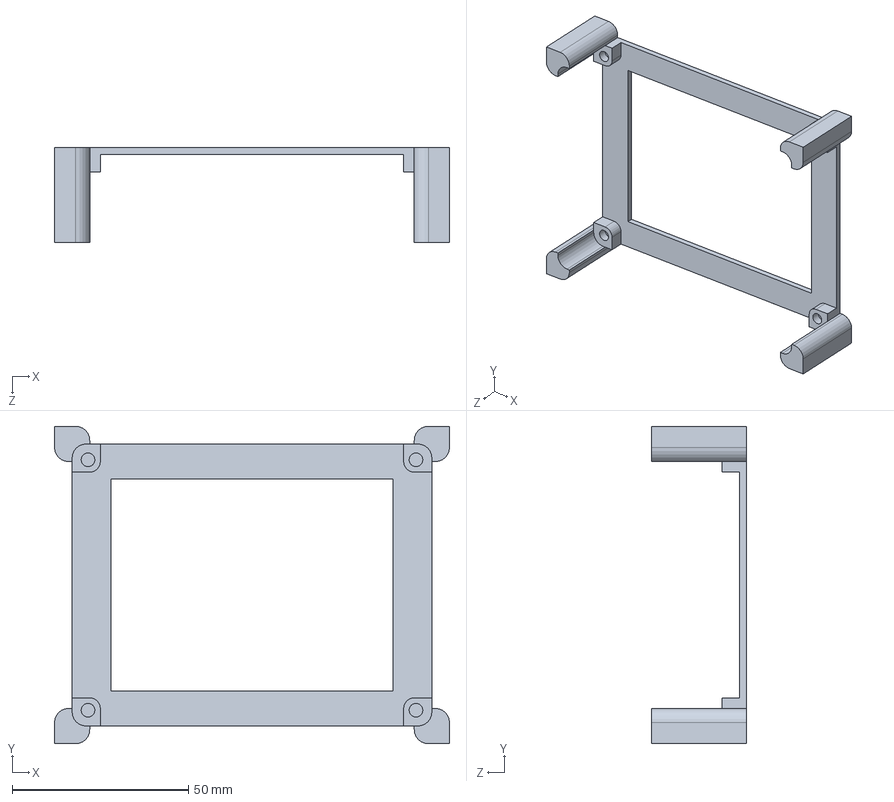
[picture p16: CAD file, 2024-01-09]
case/pcb_mount.SLDPRT
112.0 x 90.0 x 27.0 mm
