gth758y/poe_garHAge/case/cover.SLDPRT

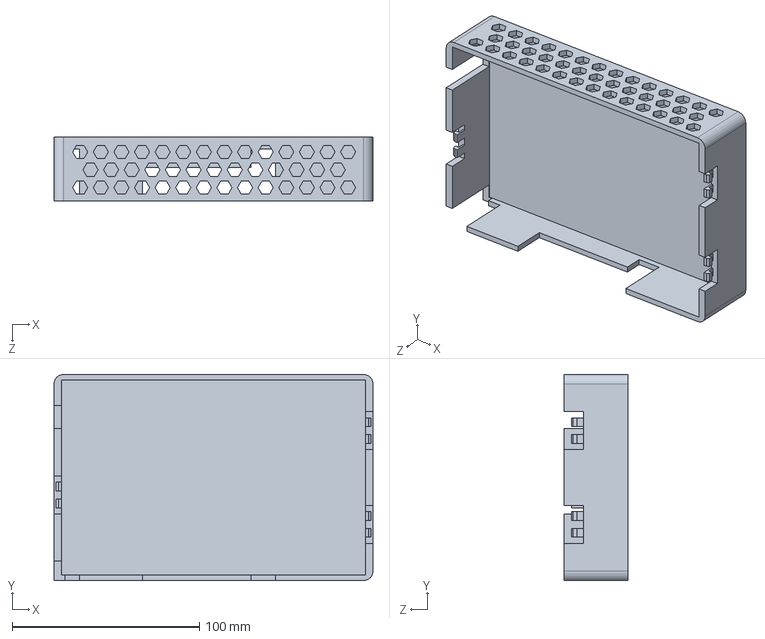
[picture p17: CAD file, 2024-01-09]
case/cover.SLDPRT
170.3 x 110.0 x 34.2 mm
