gth758y/poe_garHAge/(list of files, cad)

Other CAD files:
case/2gang_oldwork.skp
kicad/cad/PG02S4803A.SLDPRT
