gth758y/poe_garHAge/garHAge_v2 Schematic.pdf

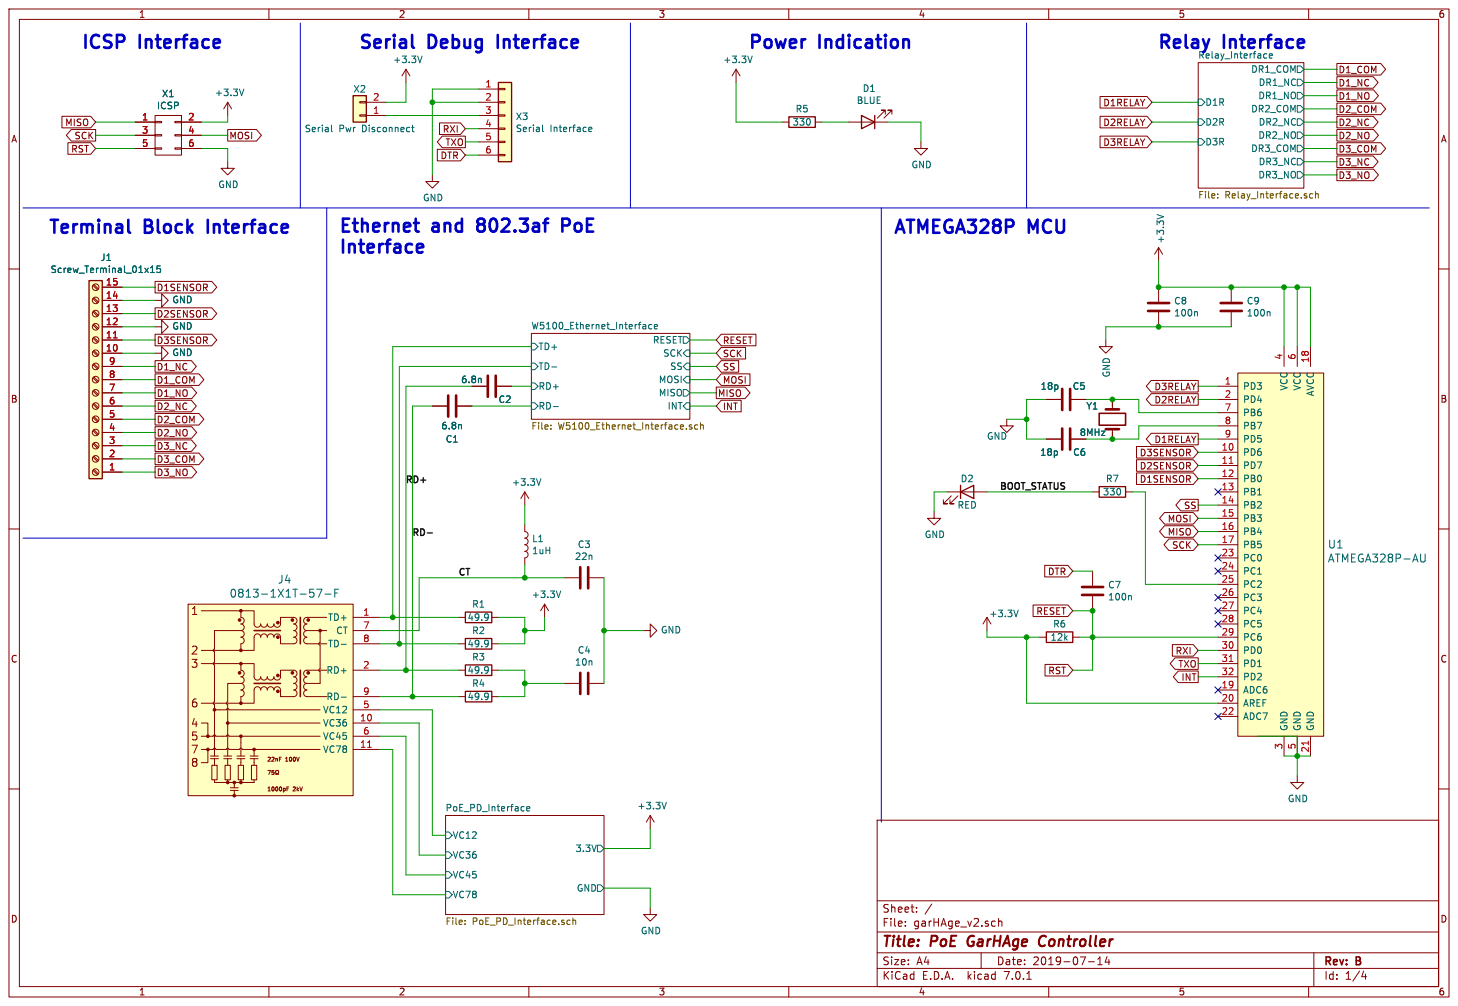
[picture p18: page 1]

Id: 1/4 Title: PoE GarHAge Controller File: garHAge_v2.sch Sheet: /

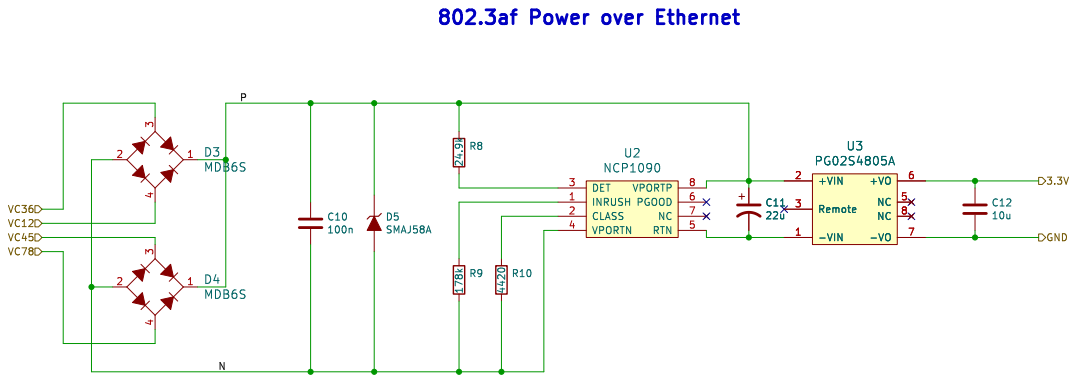
[picture p19: page 2]

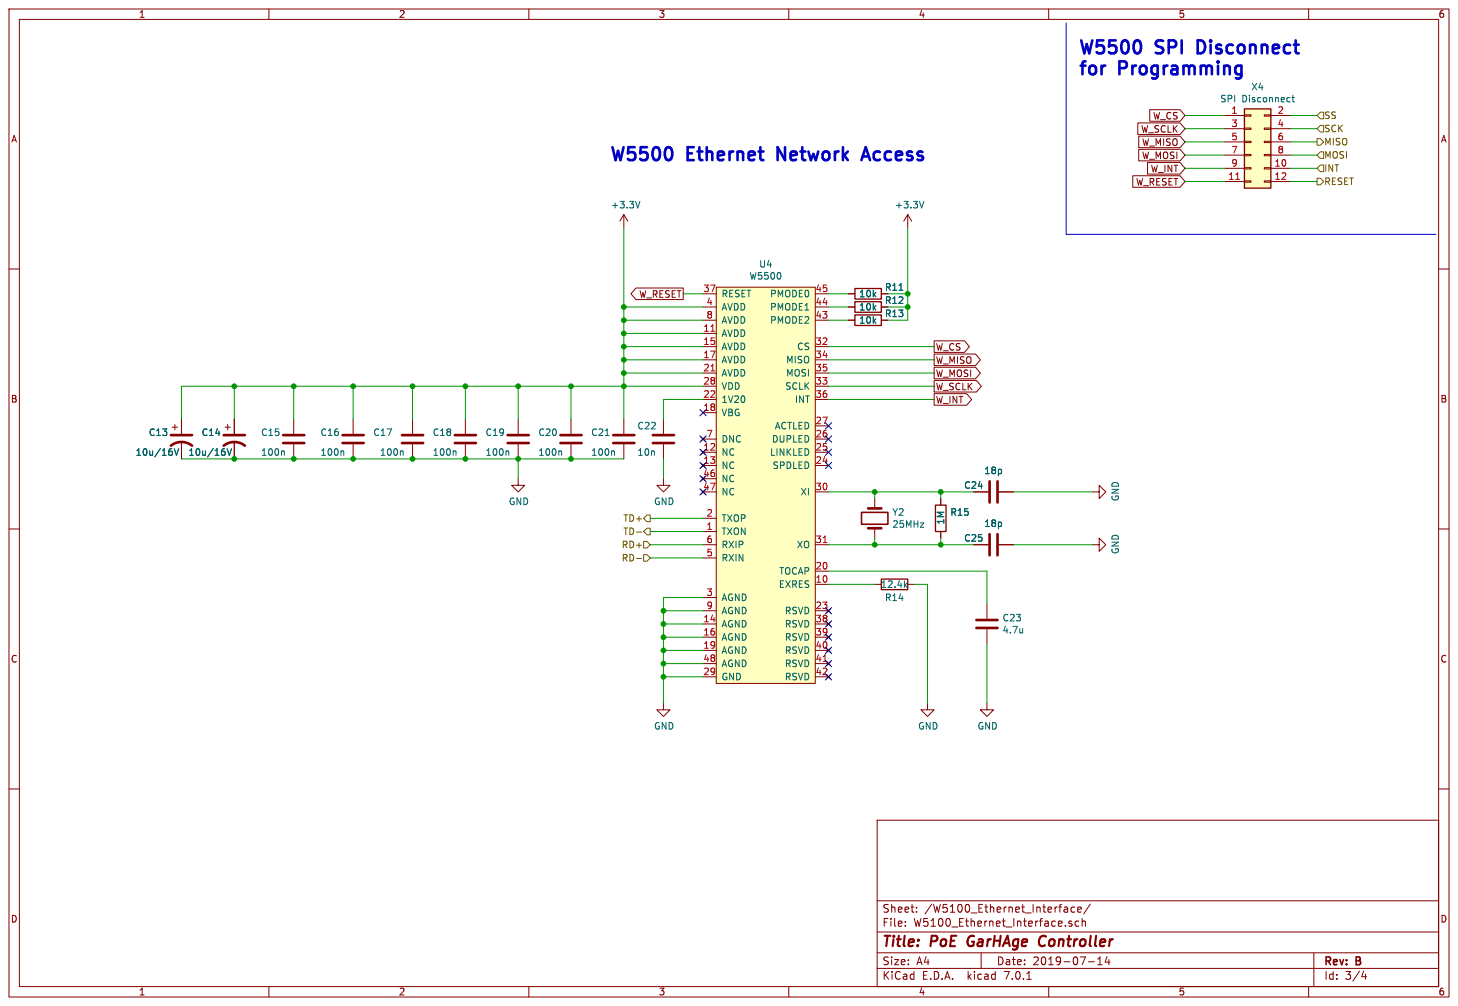
[picture p20: page 3]

Id: 3/4 Title: PoE GarHAge Controller File: W5100_Ethernet_Interface.sch Sheet: /W5100_Ethernet_Interface/

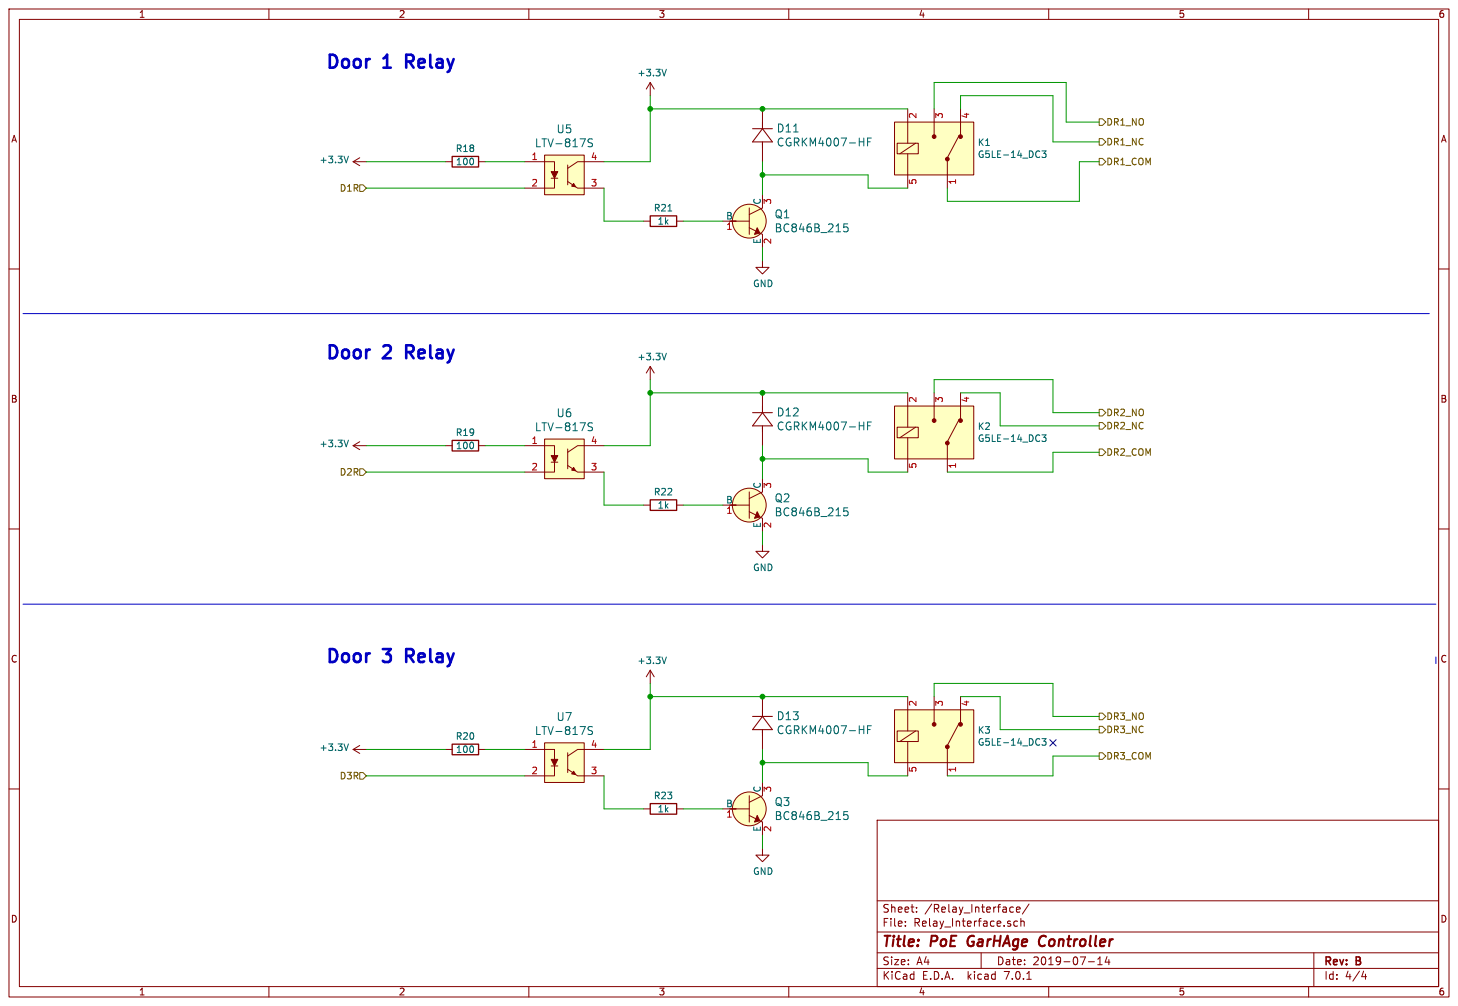
[picture p21: page 4]
