gth758y/poe_garHAge/kicad/garHAge_v2 Schematic.pdf

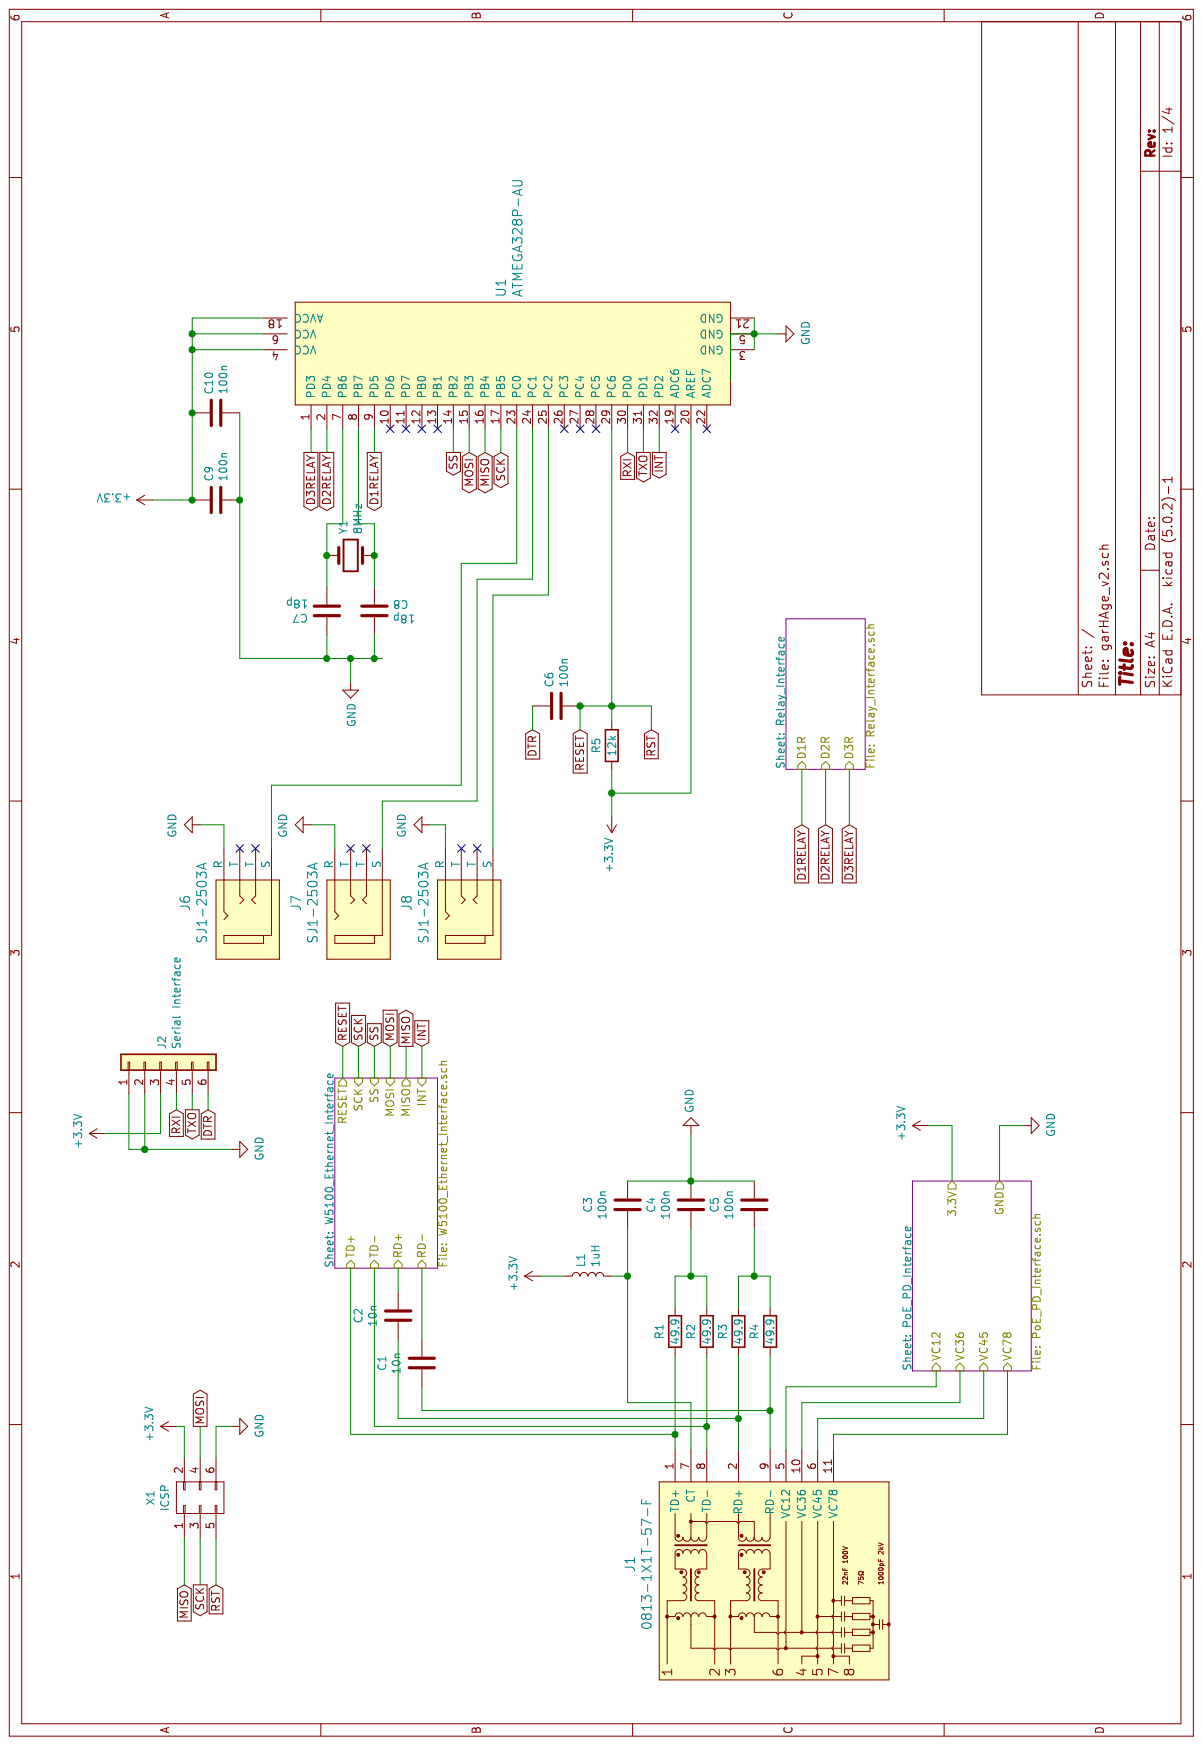
[picture p22: page 1]

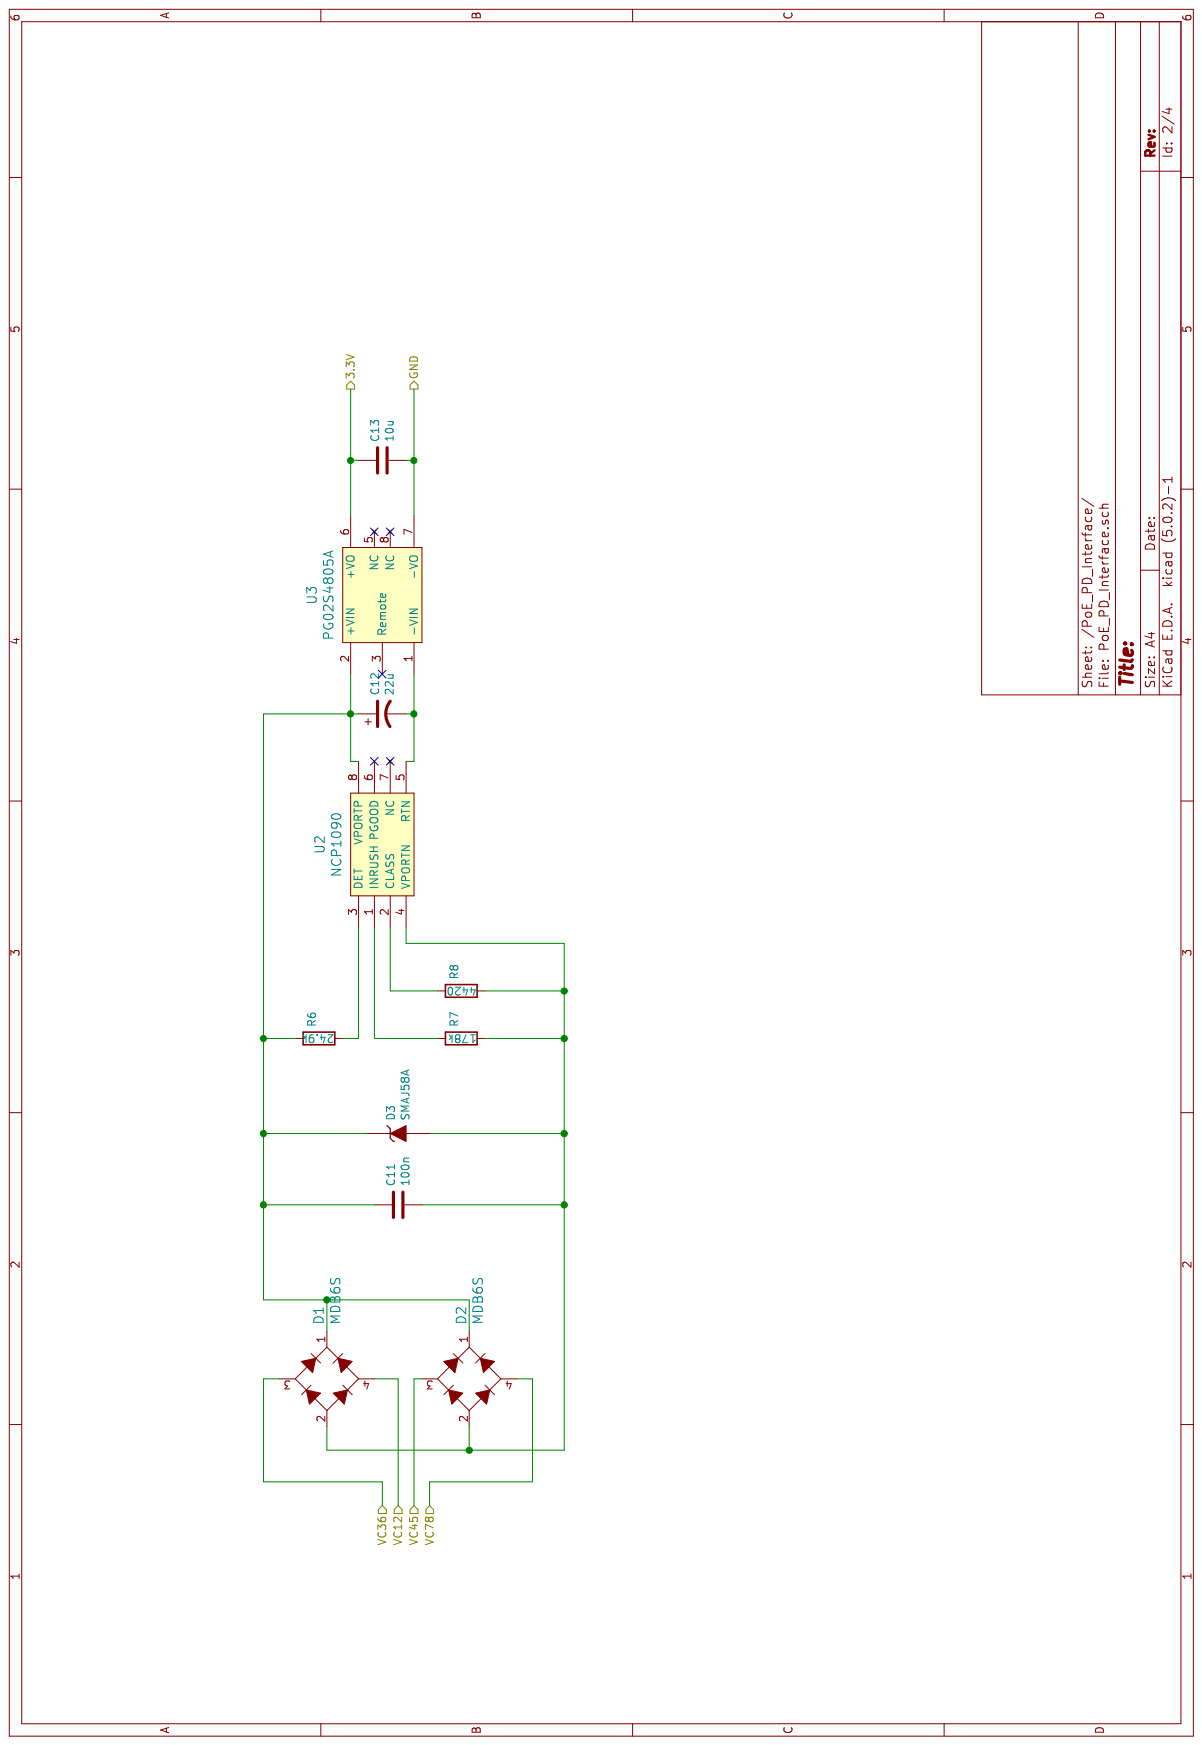
[picture p23: page 2]

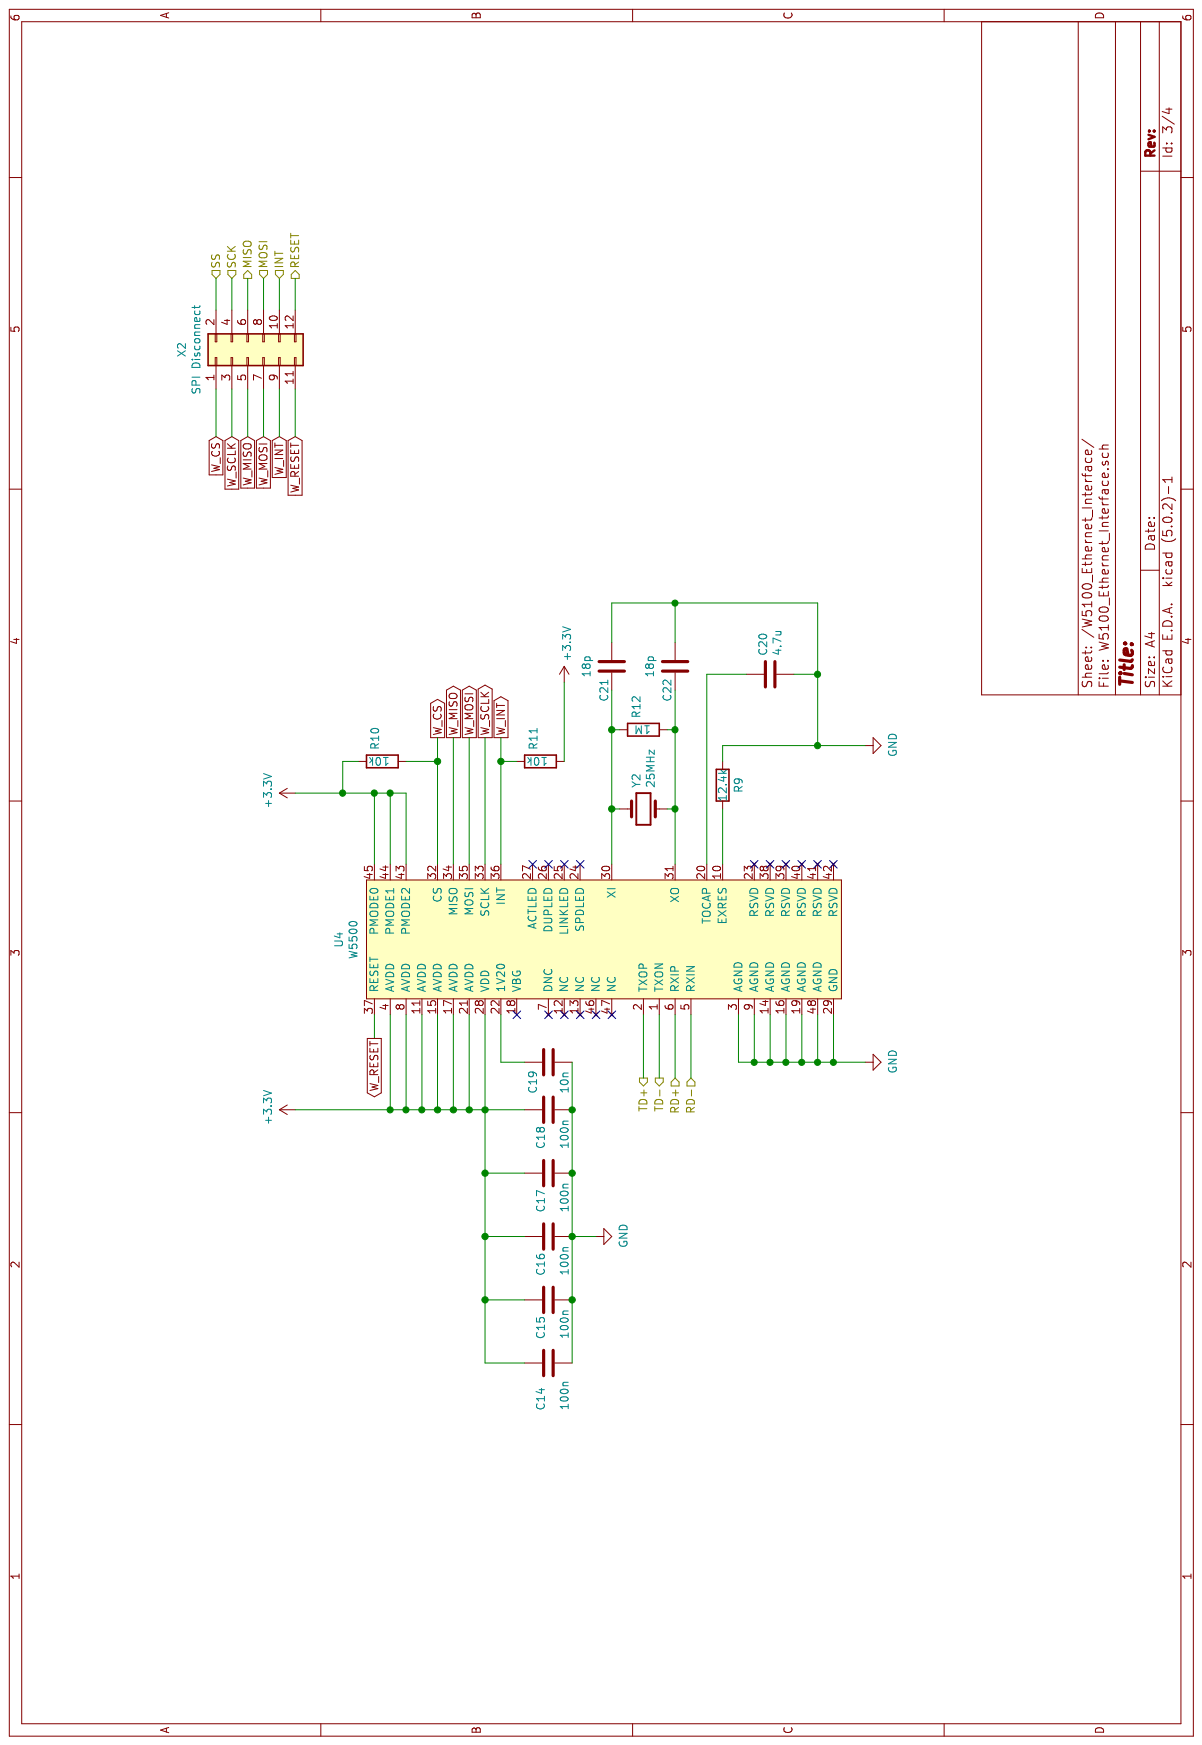
[picture p24: page 3]

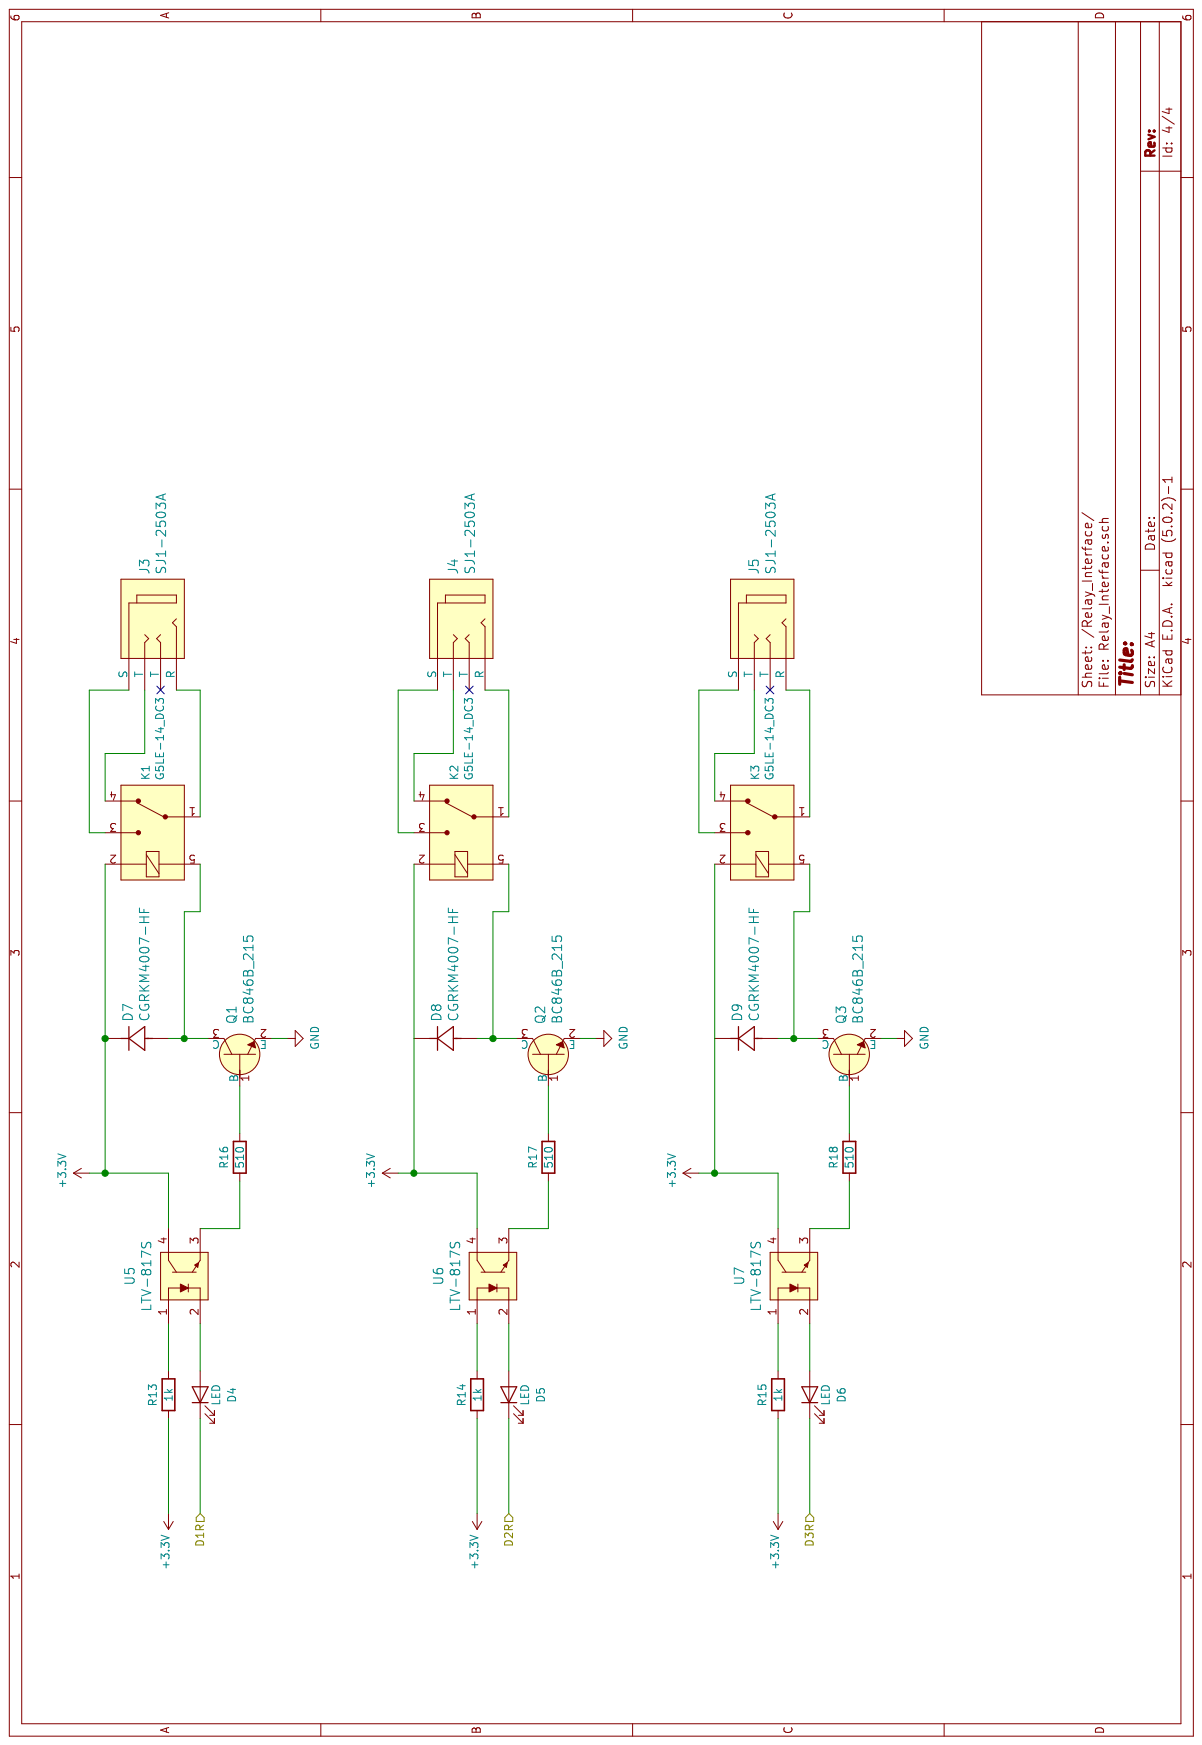
[picture p25: page 4]
