gth758y/poe_garHAge/kicad/garHAge_v2.kicad_pcb

## KiCad design kicad/garHAge_v2.kicad_pcb (2019-07-15)

Schematic: garHAge_v2.sch

Parts:
C1, C2: 6.8n; C_0805_2012Metric
C3: 22n; C_0805_2012Metric
C4: 10n; C_0805_2012Metric
C5, C6: 18p; C_0603_1608Metric
C7, C8, C9: 100n; C_0805_2012Metric
D1: BLUE; LED_1206_3216Metric_Pad1.42x1.75mm_HandSolder
D2: RED; LED_1206_3216Metric_Pad1.42x1.75mm_HandSolder
J1, J2, J3: SJ1-2503A; Headphone_Jack_2.5mm_SJ1-2503A; MPN SJ1-2503A; Digi-Key_PN CP1-2503A-ND
J4: 0813-1X1T-57-F; 0813-1X1T-57-F_RJ45-Jack; DigiKey Part Number 507-1421-ND
L1: 1uH; C_0805_2012Metric
R1, R2, R3, R4: 49.9; R_0805_2012Metric
R5, R7: 330; R_0805_2012Metric
R6: 12k; R_0805_2012Metric
U1: ATMEGA328P-AU; TQFP-32_7x7mm; MPN ATMEGA328P-AU; Digi-Key_PN ATMEGA328P-AU-ND
X1: ICSP; PinHeader_2x03_P2.54mm_Vertical
X2: Serial Pwr Disconnect; PinHeader_1x02_P2.54mm_Vertical
X3: Serial Interface; PinHeader_1x06_P2.54mm_Horizontal
Y1: 8MHz; Crystal_SMD_5032-2Pin_5.0x3.2mm

Connections:
+3V3: C8.1, C9.1, L1.1, R1.1, R2.1, R5.2, R6.2, U1.4 (VCC), U1.6 (VCC), U1.18 (AVCC), U1.20 (AREF), X1.2, X2.2; also elsewhere on the board
/BOOT_STATUS: D2.2 (A), R7.2
/CT: C3.2, J4.7 (CT), L1.2
/PoE_PD_Interface/VC12: J4.5 (VC12); also elsewhere on the board
/PoE_PD_Interface/VC36: J4.10 (VC36); also elsewhere on the board
/PoE_PD_Interface/VC45: J4.6 (VC45); also elsewhere on the board
/PoE_PD_Interface/VC78: J4.11 (VC78); also elsewhere on the board
/RD+: C2.2, J4.2 (RD+), R3.2
/RD-: C1.2, J4.9 (RD-), R4.2
/W5100_Ethernet_Interface/RD+: C2.1; also elsewhere on the board
/W5100_Ethernet_Interface/RD-: C1.1; also elsewhere on the board
/W5100_Ethernet_Interface/TD+: J4.1 (TD+), R1.2; also elsewhere on the board
/W5100_Ethernet_Interface/TD-: J4.8 (TD-), R2.2; also elsewhere on the board
D1RELAY: U1.9 (PD5); also elsewhere on the board
D1SENSOR: J1.1 (S), U1.10 (PD6)
D2RELAY: U1.2 (PD4); also elsewhere on the board
D2SENSOR: J2.1 (S), U1.11 (PD7)
D3RELAY: U1.1 (PD3); also elsewhere on the board
D3SENSOR: J3.1 (S), U1.12 (PB0)
DTR: C7.1, X3.6
GND: C3.1, C4.1, C5.1, C6.2, C8.2, C9.2, D1.1 (K), D2.1 (K), J1.4 (R), J2.4 (R), J3.4 (R), U1.3 (GND), U1.5 (GND), U1.21 (GND), X1.6, X3.1, X3.2; also elsewhere on the board
INT: U1.32 (PD2); also elsewhere on the board
MISO: U1.16 (PB4), X1.1; also elsewhere on the board
MOSI: U1.15 (PB3), X1.4; also elsewhere on the board
unnamed: C4.2, R3.1, R4.1
unnamed: C5.2, U1.7 (PB6), Y1.1
unnamed: C6.1, U1.8 (PB7), Y1.2
unnamed: D1.2 (A), R5.1
unnamed: R7.1, U1.25 (PC2)
unnamed: X2.1, X3.3
RESET: C7.2, R6.1, U1.29 (PC6), X1.5; also elsewhere on the board
RXI: U1.30 (PD0), X3.4
SCK: U1.17 (PB5), X1.3; also elsewhere on the board
SS: U1.14 (PB2); also elsewhere on the board
TXO: U1.31 (PD1), X3.5

Notes on the sheet:
ICSP Interface
Serial Debug Interface
Power Indication
Relay Interface
Reed Switch Interface
Ethernet and 802.3af PoE Interface
ATMEGA328P MCU

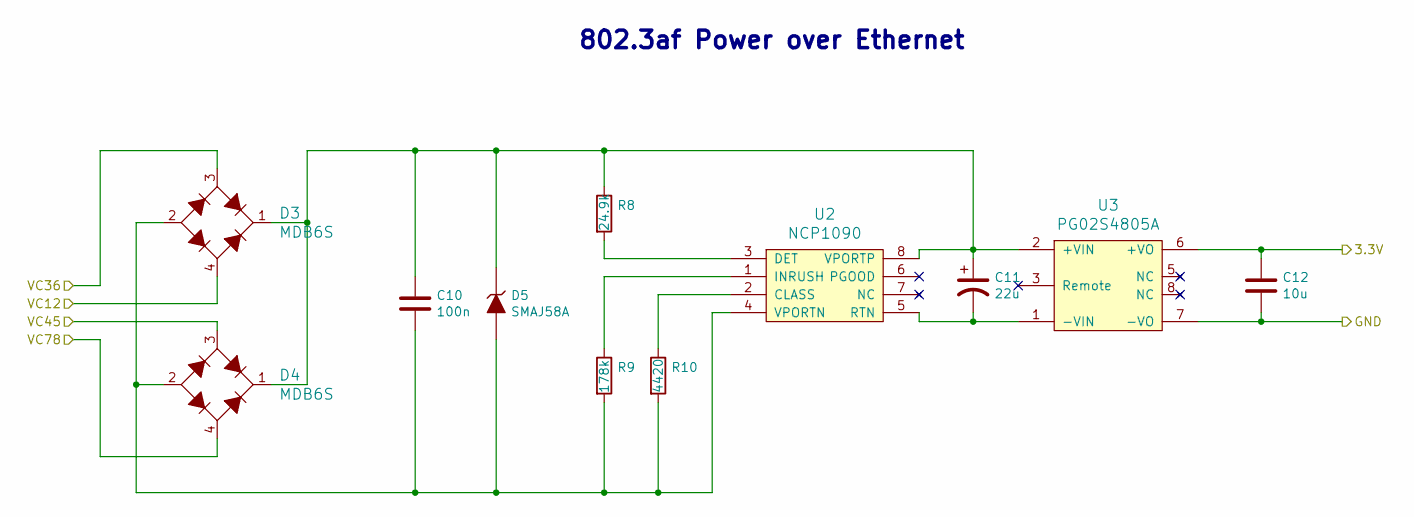
[picture p26: schematic PoE_PD_Interface.sch]

Parts:
C10: 100n; C_0805_2012Metric
C11: 22u; CP_Radial_D5.0mm_P2.00mm
C12: 10u; C_0805_2012Metric
D3, D4: MDB6S; Micro-DIP-4; DigiKey Part Number MDB6SFSCT-ND
D5: SMAJ58A; D_SMA
R8: 24.9k; R_0805_2012Metric
R9: 178k; R_0805_2012Metric
R10: 4420; R_0805_2012Metric
U2: NCP1090; SOIC-8_3.9x4.9mm_P1.27mm; DigiKey Part Number NCP1090DGOS-ND
U3: PG02S4805A; PG02S; DigiKey Part Number 941-1186-ND

Connections:
+3V3: C12.1, U3.6 (+VO); also elsewhere on the board
/PoE_PD_Interface/VC12: D3.4 (AC2); also elsewhere on the board
/PoE_PD_Interface/VC36: D3.3 (AC1); also elsewhere on the board
/PoE_PD_Interface/VC45: D4.3 (AC1); also elsewhere on the board
/PoE_PD_Interface/VC78: D4.4 (AC2); also elsewhere on the board
GND: C12.2, U3.7 (-VO); also elsewhere on the board
unnamed: C10.1, C11.1, D3.1 (+), D4.1 (+), D5.1 (K), R8.1, U2.8 (VPORTP), U3.2 (+VIN)
unnamed: C10.2, D3.2 (-), D4.2 (-), D5.2 (A), R9.2, R10.2, U2.4 (VPORTN)
unnamed: C11.2, U2.5 (RTN), U3.1 (-VIN)
unnamed: R8.2, U2.3 (DET)
unnamed: R9.1, U2.1 (INRUSH)
unnamed: R10.1, U2.2 (CLASS)

Notes on the sheet:
802.3af Power over Ethernet

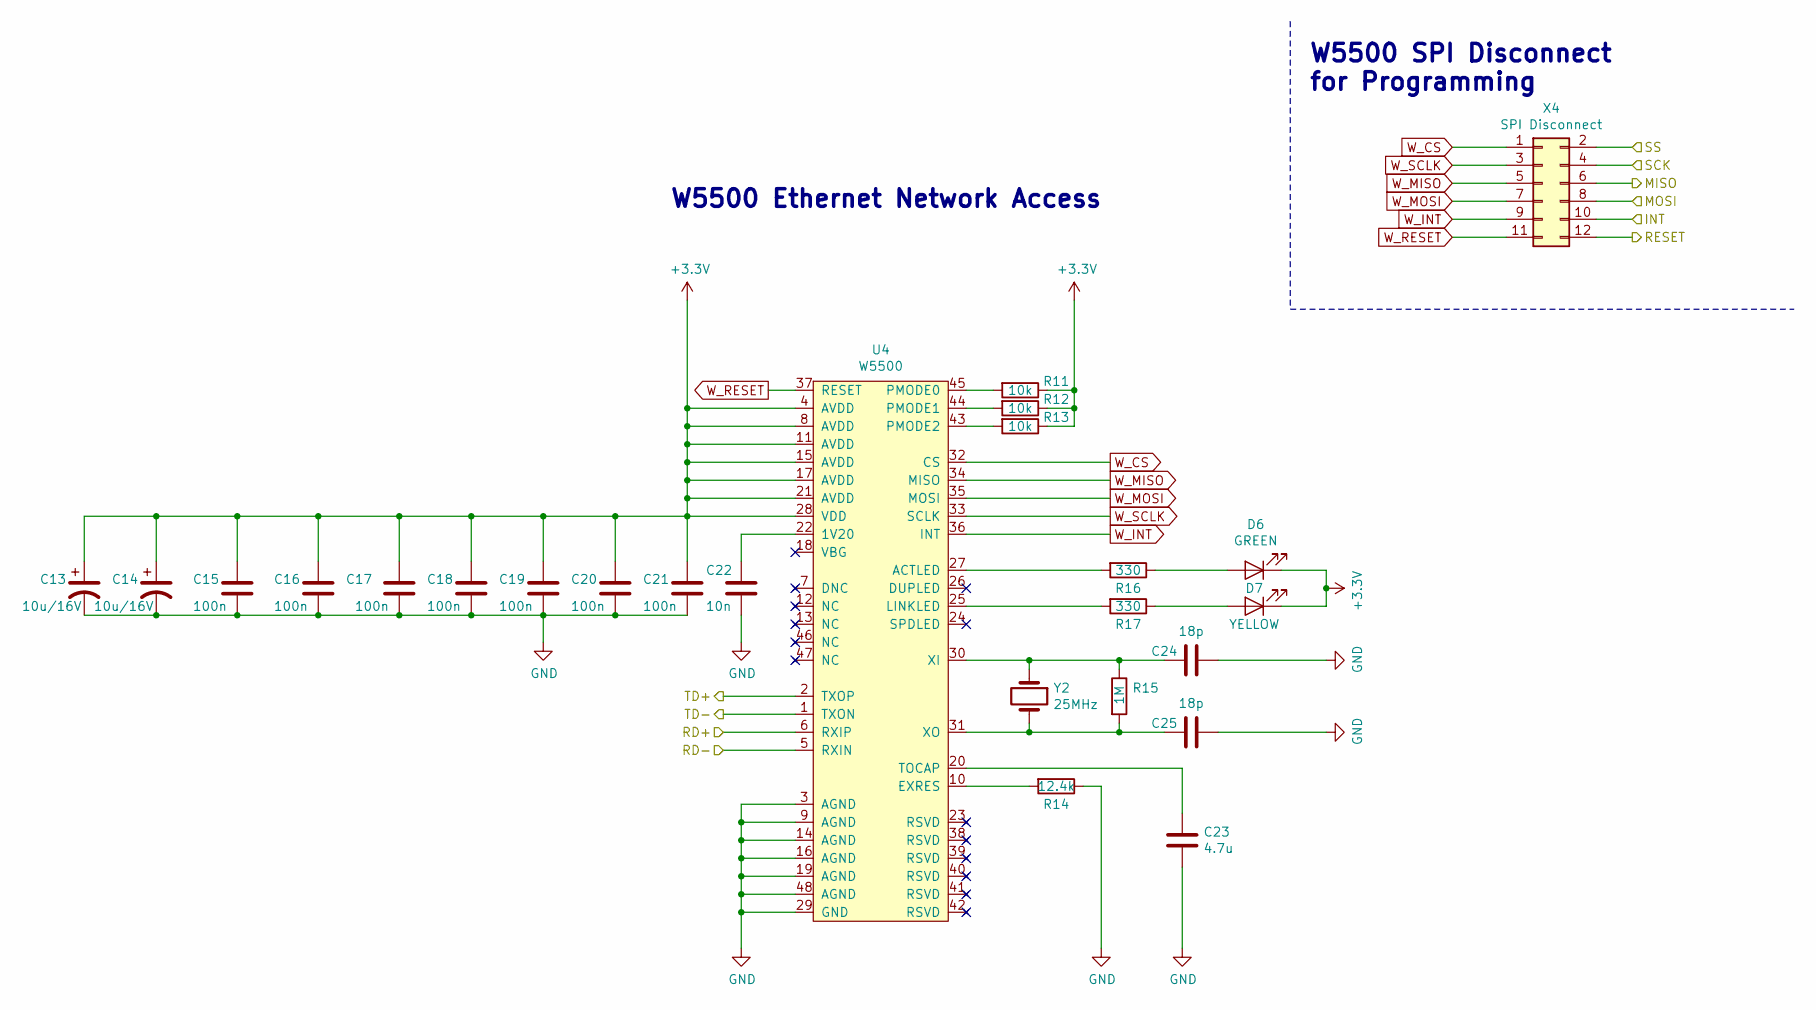
[picture p27: schematic W5100_Ethernet_Interface.sch]

Parts:
C13, C14: 10u/16V; C_0805_2012Metric
C15, C16, C17, C18, C19, C20, C21: 100n; C_0805_2012Metric
C22: 10n; C_0805_2012Metric
C23: 4.7u; C_0805_2012Metric
C24, C25: 18p; C_0603_1608Metric
D6: GREEN; LED_1206_3216Metric_Pad1.42x1.75mm_HandSolder
D7: YELLOW; LED_1206_3216Metric_Pad1.42x1.75mm_HandSolder
R11, R12, R13: 10k; R_0805_2012Metric
R14: 12.4k; R_0805_2012Metric
R15: 1M; R_0805_2012Metric
R16, R17: 330; R_0805_2012Metric
U4: W5500; LQFP-48_7x7mm_P0.5mm
X4: SPI Disconnect; PinHeader_2x06_P2.54mm_Vertical
Y2: 25MHz; Crystal_SMD_5032-2Pin_5.0x3.2mm

Connections:
+3V3: C13.1, C14.1, C15.1, C16.1, C17.1, C18.1, C19.1, C20.1, C21.1, D6.1 (K), D7.1 (K), R11.1, R12.1, R13.1, U4.4 (AVDD), U4.8 (AVDD), U4.11 (AVDD), U4.15 (AVDD), U4.17 (AVDD), U4.21 (AVDD), U4.28 (VDD); also elsewhere on the board
/W5100_Ethernet_Interface/RD+: U4.6 (RXIP); also elsewhere on the board
/W5100_Ethernet_Interface/RD-: U4.5 (RXIN); also elsewhere on the board
/W5100_Ethernet_Interface/TD+: U4.2 (TXOP); also elsewhere on the board
/W5100_Ethernet_Interface/TD-: U4.1 (TXON); also elsewhere on the board
GND: C13.2, C14.2, C15.2, C16.2, C17.2, C18.2, C19.2, C20.2, C21.2, C22.2, C23.2, C24.1, C25.1, R14.1, U4.3 (AGND), U4.9 (AGND), U4.14 (AGND), U4.16 (AGND), U4.19 (AGND), U4.29 (GND), U4.48 (AGND); also elsewhere on the board
INT: X4.10; also elsewhere on the board
MISO: X4.6; also elsewhere on the board
MOSI: X4.8; also elsewhere on the board
unnamed: C22.1, U4.22 (1V20)
unnamed: C23.1, U4.20 (TOCAP)
unnamed: C24.2, R15.1, U4.30 (XI), Y2.1
unnamed: C25.2, R15.2, U4.31 (XO), Y2.2
unnamed: D6.2 (A), R16.1
unnamed: D7.2 (A), R17.1
unnamed: R11.2, U4.45 (PMODE0)
unnamed: R12.2, U4.44 (PMODE1)
unnamed: R13.2, U4.43 (PMODE2)
unnamed: R14.2, U4.10 (EXRES)
unnamed: R16.2, U4.27 (ACTLED)
unnamed: R17.2, U4.25 (LINKLED)
RESET: X4.12; also elsewhere on the board
SCK: X4.4; also elsewhere on the board
SS: X4.2; also elsewhere on the board
W_CS: U4.32 (CS), X4.1
W_INT: U4.36 (INT), X4.9
W_MISO: U4.34 (MISO), X4.5
W_MOSI: U4.35 (MOSI), X4.7
W_RESET: U4.37 (RESET), X4.11
W_SCLK: U4.33 (SCLK), X4.3

Notes on the sheet:
W5500 SPI Disconnect for Programming
W5500 Ethernet Network Access

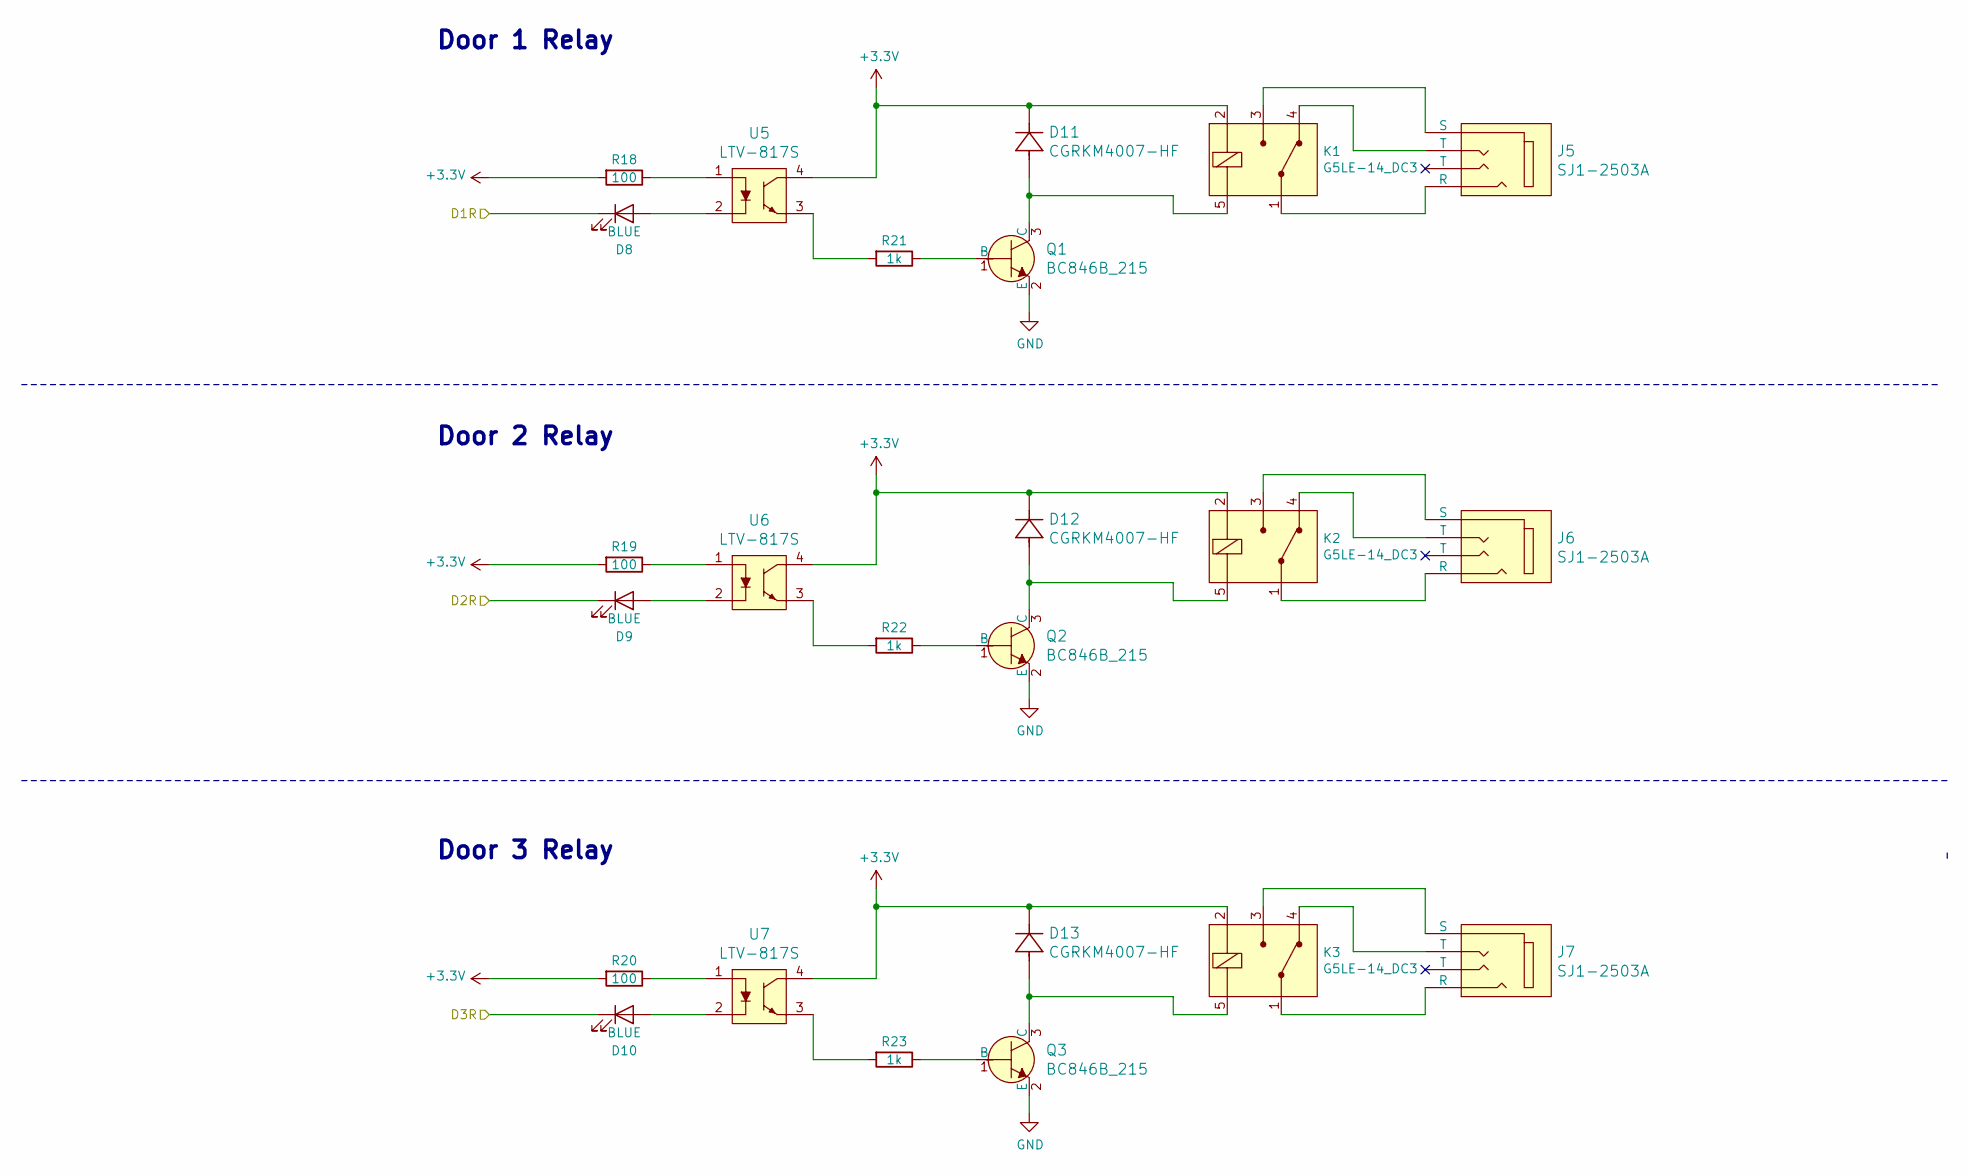
[picture p28: schematic Relay_Interface.sch]

Parts:
D8, D9, D10: BLUE; LED_1206_3216Metric_Pad1.42x1.75mm_HandSolder
D11, D12, D13: CGRKM4007-HF; D_SOD-123F
J5, J6, J7: SJ1-2503A; Headphone_Jack_2.5mm_SJ1-2503A; MPN SJ1-2503A; Digi-Key_PN CP1-2503A-ND
K1, K2, K3: G5LE-14_DC3; Relay_THT_G5LE-14; MPN G5LE-14 DC3; Digi-Key_PN Z3326-ND
Q1, Q2, Q3: BC846B_215; SOT-23-3; MPN BC846B,215; Digi-Key_PN 1727-2920-1-ND
R18, R19, R20: 100; R_0805_2012Metric
R21, R22, R23: 1k; R_0805_2012Metric
U5: LTV-817S; DIP-4_SMD_GullWing; MPN LTV-817; Digi-Key_PN 160-1366-5-ND
U6, U7: LTV-817S; DIP-4_SMD_GullWing; MPN LTV-817S; Digi-Key_PN 160-1366-5-ND

Connections:
+3V3: D11.1, D12.1, D13.1, K1.2 (COIL), K2.2 (COIL), K3.2 (COIL), R18.2, R19.2, R20.2, U5.4, U6.4, U7.4; also elsewhere on the board
D1RELAY: D8.1 (K); also elsewhere on the board
D2RELAY: D9.1 (K); also elsewhere on the board
D3RELAY: D10.1 (K); also elsewhere on the board
GND: Q1.2 (E), Q2.2 (E), Q3.2 (E); also elsewhere on the board
unnamed: D8.2 (A), U5.2
unnamed: D9.2 (A), U6.2
unnamed: D10.2 (A), U7.2
unnamed: D11.2, K1.5 (COIL), Q1.3 (C)
unnamed: D12.2, K2.5 (COIL), Q2.3 (C)
unnamed: D13.2, K3.5 (COIL), Q3.3 (C)
unnamed: J5.1 (S), K1.3 (NO)
unnamed: J5.3 (T), K1.4 (NC)
unnamed: J5.4 (R), K1.1 (COM)
unnamed: J6.1 (S), K2.3 (NO)
unnamed: J6.3 (T), K2.4 (NC)
unnamed: J6.4 (R), K2.1 (COM)
unnamed: J7.1 (S), K3.3 (NO)
unnamed: J7.3 (T), K3.4 (NC)
unnamed: J7.4 (R), K3.1 (COM)
unnamed: Q1.1 (B), R21.1
unnamed: Q2.1 (B), R22.1
unnamed: Q3.1 (B), R23.1
unnamed: R18.1, U5.1
unnamed: R19.1, U6.1
unnamed: R20.1, U7.1
unnamed: R21.2, U5.3
unnamed: R22.2, U6.3
unnamed: R23.2, U7.3

Notes on the sheet:
Door 1 Relay
Door 2 Relay
Door 3 Relay

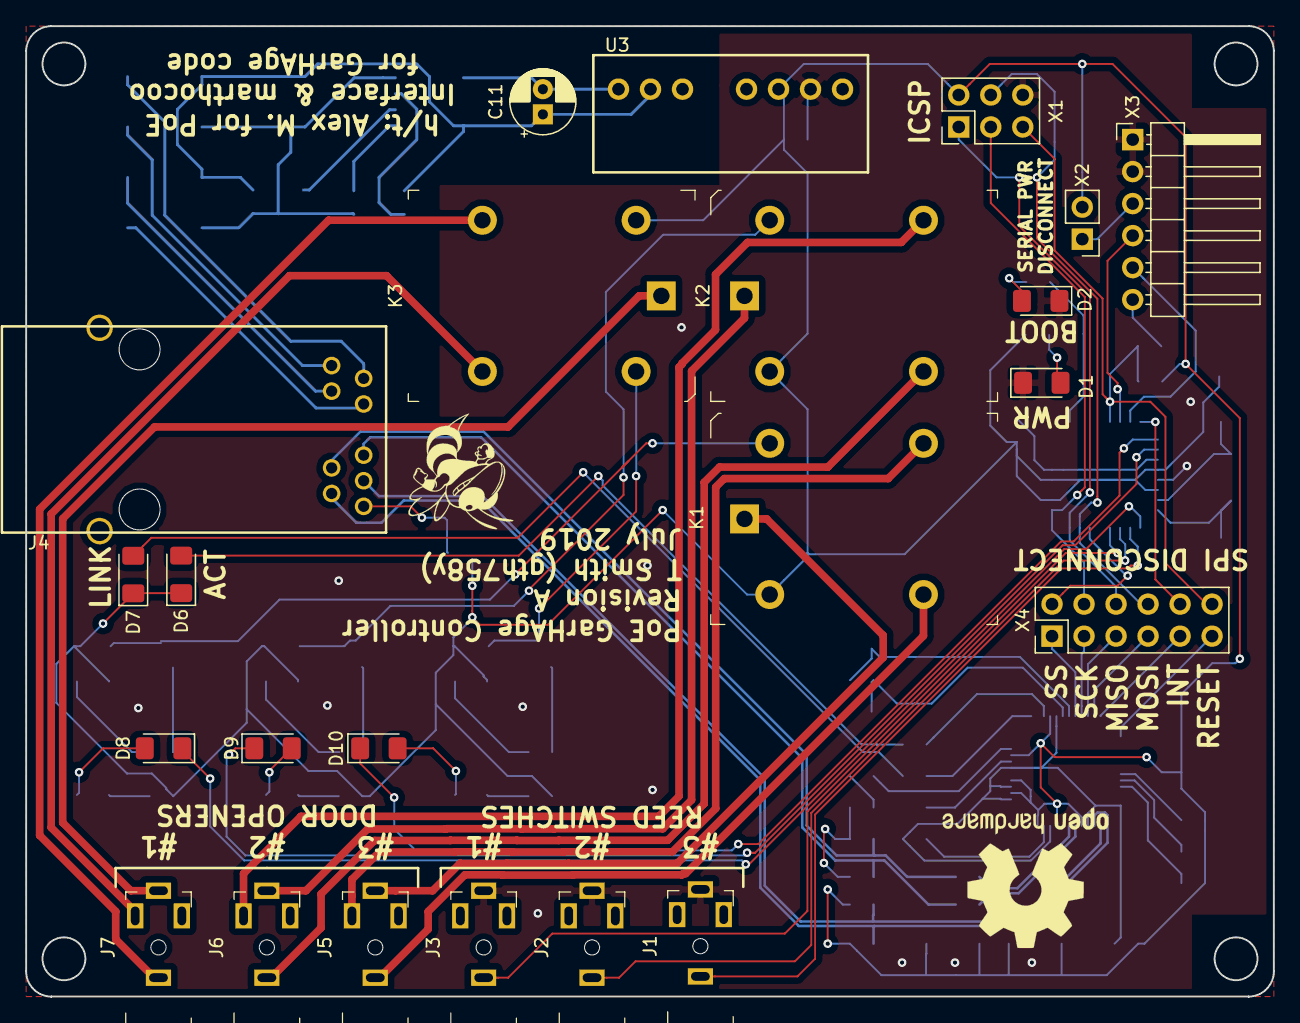
[picture p29: board garHAge_v2.kicad_pcb from above]

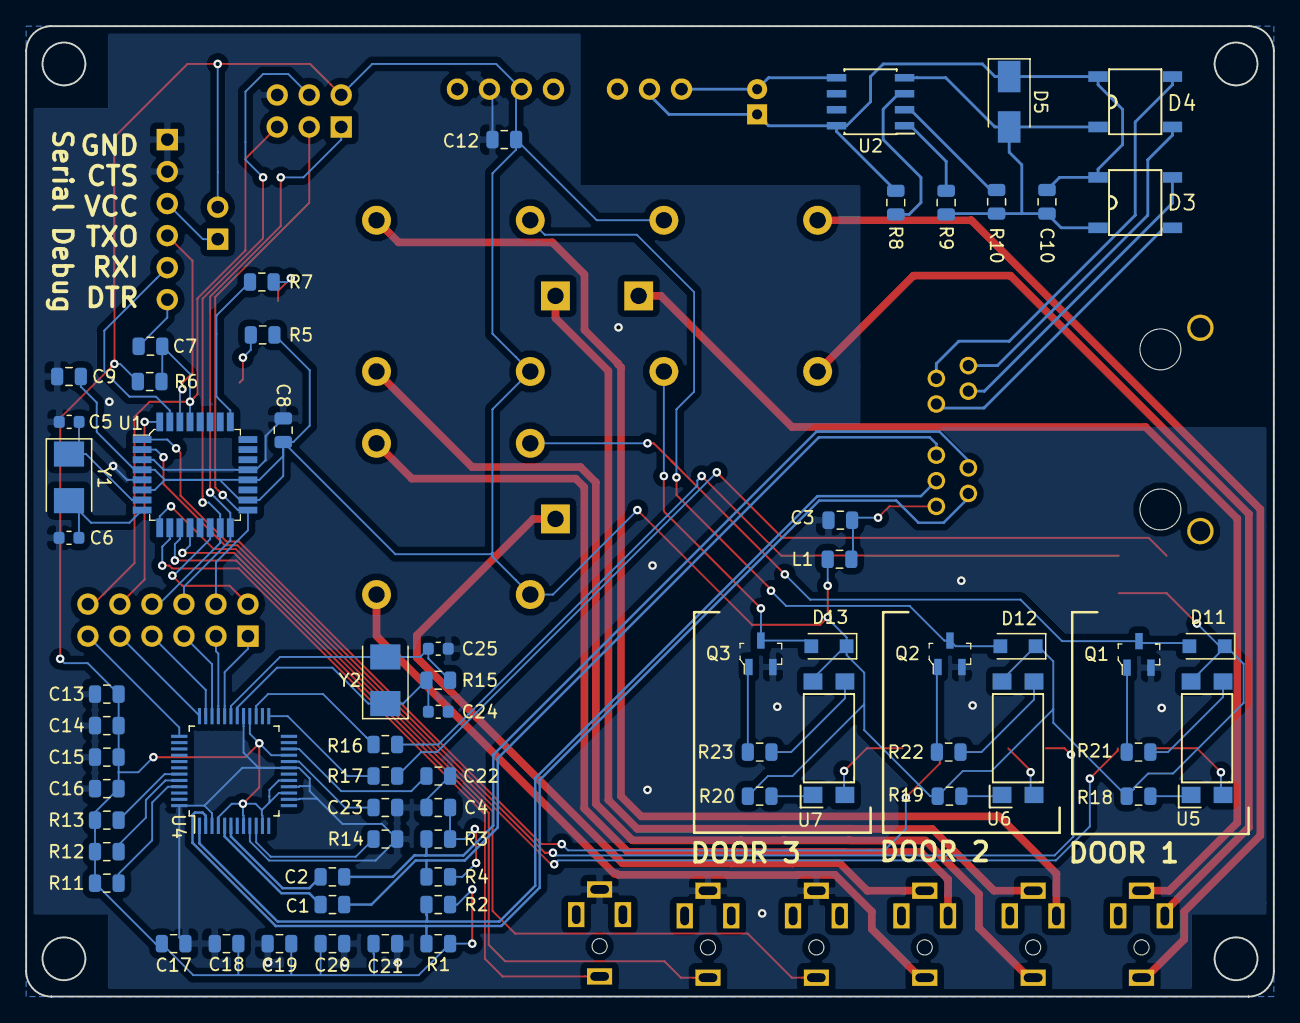
[picture p30: board garHAge_v2.kicad_pcb from below]

Board: 2 copper layers, 99.0 x 77.0 mm, 88 parts (65 on the bottom side), 83 nets.
